luruicheng891/Study-Focus-Meter/项目架构.png

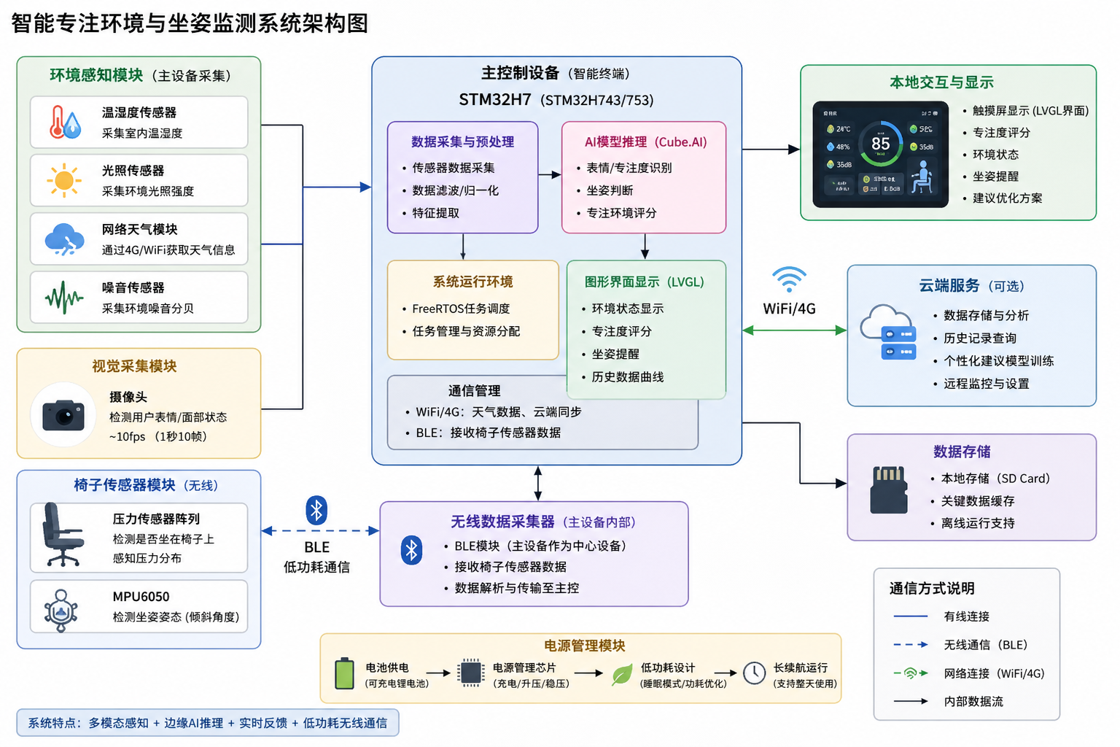
项目架构.png
