luruicheng891/Study-Focus-Meter/开发笔记.md

# AI 学习状态监测仪 开发笔记

---

## 一、项目元信息

| 项目 | 内容 |
|---|---|
| 产品名称 | AI 学习状态监测仪 |
| 固件版本 | V1.5 |
| MCU | STM32H723ZGT6 (Cortex-M7, 550MHz) |
| 摄像头模块 | OV2640 (SCCB 接口, 最大 1600×1200) |
| LCD 模块 | ILI9341 (240×320 原始, 横屏使用为 320×240, SPI 接口, RGB565) |
| 温湿度传感器 | AHT20 (I2C, 地址 0x38) |
| 光照传感器 | BH1750FVI (I2C, 地址 0x23, ADDR=GND) |
| 六轴传感器 | MPU6050 (从机端, 通过蓝牙透传) |
| 蓝牙模块 | 安信可 PB-03F (BLE 5.2, UART 透传) |

### 开发环境

| 项目 | 版本/说明 |
|---|---|
| IDE | Keil MDK-ARM V5 |
| 编译器 | ARM Compiler V5 (armcc) |
| 固件库 | STM32H7xx HAL Driver |
| RTOS | FreeRTOS Kernel V10.3.1 + CMSIS-RTOS V2 |
| GUI 库 | LVGL v8.3.11 |
| 调试器 | ST-Link / J-Link |

### 关键文档链接

- 数据手册: [STM32H723ZGT6 Datasheet](https://www.st.com/resource/en/datasheet/stm32h723zg.pdf)
- 参考手册: [RM0468 - STM32H723/733 Reference Manual](https://www.st.com/resource/en/reference_manual/rm0468-stm32h723733-stm32h725735-and-stm32h730-value-line-advanced-armbased-32bit-mcus-stmicroelectronics.pdf)
- OV2640 数据手册: OV2640 Camera Module Datasheet (Omnivision)
- ILI9341 数据手册: ILI9341 TFT LCD Controller Datasheet

---

## 二、硬件抽象层笔记

### 2.1 时钟树配置

```
HSE = 25MHz (外部高速晶振，假设板载为 25MHz)

PLL1 配置:
  PLLM = 10  → VCO 输入 = 25MHz / 10 = 2.5MHz
  PLLN = 220 → VCO 输出 = 2.5MHz × 220 = 550MHz
  PLLP = 1   → SYSCLK = 550MHz / 1 = 550MHz
  PLLQ = 2   → PLL1Q = 275MHz
  PLLR = 2   → PLL1R = 275MHz

总线时钟:
  SYSCLK   = 550 MHz
  AHB/HCLK = 550 / 2 = 275 MHz
  APB1     = 275 / 2 = 137.5 MHz
  APB2     = 275 / 2 = 137.5 MHz
  APB3     = 275 / 2 = 137.5 MHz
  APB4     = 275 / 2 = 137.5 MHz

电压调节: VOS0 (最高性能模式)
Flash 等待周期: FLASH_LATENCY_3
```

**注意事项:**
- 使用 `PWR_LDO_SUPPLY` 供电模式
- 必须等待 `PWR_FLAG_VOSRDY` 后才能配置 PLL
- ICache 和 DCache 均已开启 (`SCB_EnableICache()` / `SCB_EnableDCache()`)

### 2.2 MPU 配置

| 区域 | 基地址 | 大小 | 属性 |
|---|---|---|---|
| Region 0 | 0x24000000 (AXI SRAM) | 512KB | Full Access, Bufferable, Cacheable, Shareable |

> 用途: 摄像头 DMA 帧缓冲区放置在 AXI SRAM，配置为可缓存+可共享，确保 DMA 与 CPU 数据一致性。

### 2.3 引脚分配表

#### DCMI 接口 (OV2640 摄像头)

| 引脚 | 信号名 | 类型 | 备注 |
|---|---|---|---|
| PA6 | DCMI_PIXCLK | AF13 推挽 | 像素时钟 |
| PG9 | DCMI_VSYNC | AF13 推挽 | 垂直同步 |
| PC6 | DCMI_D0 | AF13 推挽 | 数据位 0 |
| PC7 | DCMI_D1 | AF13 推挽 | 数据位 1 |
| PG10 | DCMI_D2 | AF13 推挽 | 数据位 2 (注释标注) |
| PG11 | DCMI_D3 | AF13 推挽 | 数据位 3 (注释标注) |
| PE4 | DCMI_D4 | AF13 推挽 | 数据位 4 |
| PD3 | DCMI_D5 | AF13 推挽 | 数据位 5 |
| PE5 | DCMI_D6 | AF13 推挽 | 数据位 6 |
| PE6 | DCMI_D7 | AF13 推挽 | 数据位 7 |
| PF13 | OV2640_PWDN | GPIO 推挽输出 | 电源控制 (高=休眠) |

#### SCCB 接口 (软件模拟 I2C)

| 引脚 | 信号名 | 类型 | 备注 |
|---|---|---|---|
| PF14 | SCCB_SCL | GPIO 开漏输出 | I2C 时钟, 软件模拟 |
| PF15 | SCCB_SDA | GPIO 开漏输出 | I2C 数据, 软件模拟 |

> OV2640 设备地址: 0x60

#### SPI1 (LCD ILI9341)

| 引脚 | 信号名 | 类型 | 备注 |
|---|---|---|---|
| PB3 | SPI1_SCK | AF5 推挽 | SPI 时钟 |
| PB5 | SPI1_MOSI | AF5 推挽 | SPI 数据输出 |
| PD0 | LCD_CS | GPIO 推挽输出 | 片选 (低有效) |
| PD1 | LCD_DC | GPIO 推挽输出 | 数据/命令选择 |
| PD2 | LCD_RST | GPIO 推挽输出 | 硬件复位 (低有效) |
| PB4 | LCD_LED | GPIO 推挽输出 | 背光控制 (高=亮) |

#### USART1 (调试串口 + 显示模式命令)

| 引脚 | 信号名 | 类型 | 备注 |
|---|---|---|---|
| PA9 | USART1_TX | AF7 推挽 | 波特率 115200, 非阻塞环形缓冲 + TXE 中断 |
| PA10 | USART1_RX | AF7 输入(上拉) | 波特率 115200, RXNE 中断接收单字节命令 |

> 命令字符: `'C'`/`'c'` → 摄像头模式; `'W'`/`'w'` → 天气仪表板模式 (相对摄像头模式 180° 翻转)。
> 其它字符忽略。fputc 已重定向为非阻塞实现, 防止多任务并发 printf 死锁。

#### LED

| 引脚 | 信号名 | 类型 | 备注 |
|---|---|---|---|
| PG7 | LED1 | GPIO 推挽输出 | 低电平点亮 |

#### 软件模拟I2C

| 引脚 | 信号名 | 类型 | 备注 |
| ---- | --- | --- | --- |
| PB8  | SCL | GPIO推挽输出 | I2C时钟线 |
| PB9  | SDA | GPIO推挽输出 | I2C数据线 |

W02蓝牙模块引脚定义


### 2.4 外设配置参数

#### SPI1 (LCD) + DMA

```c
// SPI1 配置
Mode              = SPI_MODE_MASTER
Direction         = SPI_DIRECTION_2LINES_TXONLY  // 仅发送
DataSize          = SPI_DATASIZE_8BIT
CLKPolarity       = SPI_POLARITY_LOW   (CPOL=0)
CLKPhase          = SPI_PHASE_1EDGE    (CPHA=0)
BaudRatePrescaler = SPI_BAUDRATEPRESCALER_8
// APB2=137.5MHz, 分频8 → SPI CLK ≈ 17.2MHz
FirstBit          = SPI_FIRSTBIT_MSB

// DMA1_Stream0 配置 (SPI1_TX)
Request           = DMA_REQUEST_SPI1_TX (38)
Direction         = DMA_MEMORY_TO_PERIPH
PeriphDataAlignment = DMA_PDATAALIGN_BYTE
MemDataAlignment    = DMA_MDATAALIGN_BYTE
Mode              = DMA_NORMAL
Priority          = DMA_PRIORITY_HIGH
FIFOMode          = DMA_FIFOMODE_DISABLE
```

> ⚠️ DMA 缓冲区必须在 AXI SRAM (0x24000000+), 不能在 DTCM (0x20000000)!

#### DCMI

```c
SynchroMode  = DCMI_SYNCHRO_HARDWARE   // 硬件同步
PCKPolarity  = DCMI_PCKPOLARITY_RISING  // 上升沿采样
VSPolarity   = DCMI_VSPOLARITY_LOW      // VS 低电平有效
HSPolarity   = DCMI_HSPOLARITY_LOW      // HS 低电平有效
CaptureRate  = DCMI_CR_ALL_FRAME        // 捕获所有帧
数据宽度      = 8 位
```

#### FreeRTOS 关键配置

```c
configTICK_RATE_HZ        = 1000        // 1ms 节拍
configTOTAL_HEAP_SIZE     = 15360       // 15KB 堆
configMAX_PRIORITIES      = 56
configMINIMAL_STACK_SIZE  = 128 words   // 512 bytes
configTIMER_TASK_STACK_DEPTH = 256 words
Heap 实现: heap_4.c
```

#### 任务列表

| 任务名 | 函数 | 栈大小 | 优先级 | 功能 |
|---|---|---|---|---|
| LVGL_Task | LVGL_Task | 512 words (2KB) | osPriorityAboveNormal | 调用 lv_timer_handler() 驱动 LVGL |
| Camera_task | Camera_task | 1024 words (4KB) | osPriorityNormal | 摄像头采集 + LVGL canvas 显示 |
| Sensor_Task | Sensor_Task | 512 words (2KB) | osPriorityNormal | AHT20 + BH1750 + MAX9814 聚合 |
| DisplayTask | DisplayTask | 512 words (2KB) | osPriorityNormal | 三屏切换编排 + 实时刷新 + Reminder/ScreenSaver (100ms) |
| Weather_RxTask | Weather_RxTask | 512 words (2KB) | osPriorityNormal | ESP-01 USART3 帧 → cJSON → 队列 |
| Slave_RxTask | Slave_RxTask | 512 words (2KB) | osPriorityNormal | ESP32 USART2 帧 → cJSON → 队列 |
| AI_Infer | AI_InferTask | 3072 words (12KB) | osPriorityBelowNormal | CubeAI 推理 |
| Touch_Task | Touch_Task | 512 words (2KB) | osPriorityNormal | XPT2046 扫描 + LVGL indev + 校准 |
| Fusion_Task | Fusion_Task | 1024 words (4KB) | osPriorityLow | 多模态融合评分, 1s 周期 (视觉40+坐姿30+环境20+时长10) |
| State_Task | State_Task | 512 words (2KB) | osPriorityNormal | 学习会话状态机, 200ms 周期 (IDLE/PICKING/LEARNING/AWAY/PAUSED/SUMMARY) |

> 历史命名: 原 `Weather_Task` 已拆分为 `DisplayTask` (LVGL 渲染) 与 `Weather_RxTask` (数据接收), 详见第十一节重构记录。
> `Fusion_Task` / `State_Task` 为后续新增的融合与状态机任务, 配合 `LearningScreen` / `LearningReport` / `Reminder` / `ScreenSaver` 等纯 UI/逻辑模块 (无独立任务, 由 DisplayTask 驱动)。
> 界面流程与数据流详见 `项目架构.md` 的「界面流程与数据流」一节。

#### 中断优先级分配

| 中断源 | 抢占优先级 | 子优先级 | 用途 |
|---|---|---|---|
| DCMI / DMA2_Stream7 | 0 | 0 | 摄像头帧采集 (最高) |
| SPI1 DMA1_Stream0 | 1 | 0 | LCD SPI DMA 传输 |
| SPI1 | 1 | 1 | SPI 错误处理 |
| TIM7 | 3 | 0 | LVGL 1ms 心跳 |
| USART3 / DMA1_Stream1 | 6 | 0/1 | ESP-01 接收 (FreeRTOS 安全范围) |
| USART2 / DMA1_Stream3 | 6 | 0/1 | ESP32 BLE 透传接收 (FreeRTOS 安全范围) |
| USART1 | 6 | 0 | 调试串口 + 命令接收 (FreeRTOS 安全范围) |

---

## 三、驱动与中间件笔记

### 3.1 OV2640 摄像头驱动

- 像素格式: RGB565
- 采集分辨率: 400×300 (OV2640 输出)
- 显示分辨率: 240×240 (DCMI 硬件裁剪后)
- DMA 缓冲区: 位于 AXI SRAM (0x24000000)
- DMA 缓冲区大小: `240 × 240 × 2 / 4 = 28800` (32 位字)
- 传输模式: DMA 连续模式 (Continuous)

**帧处理流程:**
1. DCMI 中断回调设置 `DCMI_FrameState = 1`
2. Camera_task 检测到标志后:
   - 调用 `SCB_InvalidateDCache_by_Addr()` 使 DCache 无效化
   - 调用 `LCD_DrawBuffer()` 将帧数据刷新到 LCD

### 3.2 LCD ILI9341 驱动 (SPI1 + DMA)

- 通信方式: SPI1 (仅发送, 无 MISO) + DMA1_Stream0 加速
- 屏幕尺寸: 240×320
- 颜色格式: RGB565 (16bit)
- SPI 时钟: APB2/8 ≈ 17.2MHz
- DMA 通道: DMA1_Stream0, DMAMUX request = DMA_REQUEST_SPI1_TX (38)

**DMA 传输架构:**
- Ping-pong 双缓冲: `lcd_dma_buf[2][1024]` (每个 buffer 512 像素)
- 缓冲区位置: AXI SRAM 0x24040000 (DTCM 不可被 DMA 访问!)
- 传输前调用 `SCB_CleanDCache_by_Addr()` 刷新 DCache
- DMA 完成中断 → `HAL_SPI_TxCpltCallback()` → 清除 busy 标志
- `LCD_DMA_Wait()` 带超时保护，防止 DMA 异常时死循环

**批量传输流程 (LCD_DrawBuffer):**
1. 设置窗口 (阻塞 SPI 发送命令字节)
2. 切换 DC 为数据模式，保持 CS 低
3. 循环: CPU 在 buf[idx] 做字节序转换 → 等待上一次 DMA 完成 → 启动 DMA 发送 → 切换 idx
4. 等待最后一次 DMA 完成 → 释放 CS

**中断配置:**
- DMA1_Stream0_IRQHandler → `HAL_DMA_IRQHandler(&hdma_spi1_tx)`
- SPI1_IRQHandler → `HAL_SPI_IRQHandler(&hlcd_spi)` (错误处理)

### 3.3 I2C 软件模拟驱动

- 实现方式: GPIO bit-bang (非硬件 I2C)
- 引脚: PB8 (SCL) / PB9 (SDA), 开漏 + 内部上拉
- 速率: ~100kHz (通过 `I2C_DELAY_US = 5` 控制)
- 源文件: `Communication/I2C.c`

**API 接口:**
```c
void    I2C_Sim_Init(void);                                              // GPIO 初始化
uint8_t I2C_WriteData(uint8_t dev_addr, uint8_t reg_addr, uint8_t *data, uint16_t len);
uint8_t I2C_ReadData(uint8_t dev_addr, uint8_t reg_addr, uint8_t *buffer, uint16_t len);
```

> 注意: `dev_addr` 为 7 位地址，函数内部自动左移并添加 R/W 位。

### 3.4 MPU6050 六轴传感器驱动

- 通信接口: 软件 I2C (PB8/PB9)
- 设备地址: 0x68
- 采样率: 100Hz
- 陀螺仪量程: ±2000°/s
- 加速度计量程: ±16g
- 数字低通滤波: DLPF 带宽 5Hz
- 源文件: `Communication/MPU6050.c`

**初始化流程:**
1. 写 `PWR_MGMT_1 = 0x01` → 退出睡眠，选择 X 轴陀螺仪 PLL 作为时钟源
2. 写 `PWR_MGMT_2 = 0x00` → 使能所有轴
3. 写 `SMPLRT_DIV = 0x09` → 采样率分频 (100Hz)
4. 写 `CONFIG = 0x06` → DLPF 配置
5. 写 `GYRO_CONFIG = 0x18` → 陀螺仪 ±2000°/s
6. 写 `ACCEL_CONFIG = 0x18` → 加速度计 ±16g

**数据读取:**
- `MPU6050_GetData()` — 逐寄存器读取 (12 次 I2C 事务)
- `MPU6050_GetDataFast()` — 从 0x3B 连续读取 14 字节 (1 次 I2C 事务，推荐使用)

**寄存器映射 (连续读取 buffer[0..13]):**

| 偏移 | 内容 |
|---|---|
| [0:1] | AccX (高:低) |
| [2:3] | AccY |
| [4:5] | AccZ |
| [6:7] | Temperature (未使用) |
| [8:9] | GyroX |
| [10:11] | GyroY |
| [12:13] | GyroZ |

### 3.5 LVGL 集成

- 版本: v8.3.11
- 颜色深度: 16 bit (RGB565)
- 显示端口: `lv_port_disp.c` (位于 `LVGL/examples/porting/`)
- 刷屏回调: 调用 `LCD_SetWindows()` + `LCD_WriteDataBuffer()`
- 心跳源: TIM7 基本定时器, 1ms 中断调用 `lv_tick_inc(1)`
- `LV_TICK_CUSTOM = 0` (使用手动 tick 方式)

### 3.5.1 TIM7 LVGL 心跳定时器

- 源文件: `SYSTEM/TIM.c`, `SYSTEM/TIM.h`
- 定时器: TIM7 (基本定时器, 挂在 APB1 总线)
- 实现方式: 直接寄存器操作 (未启用 `HAL_TIM_MODULE_ENABLED`, 减少代码体积)
- 时钟来源: APB1 Timer Clock = 275MHz (APB1 分频≠1 时, Timer Clock = 2 × APB1)

**定时器参数:**

| 参数 | 值 | 说明 |
|---|-----|---|
| PSC | 274 | 275MHz / 275 = 1MHz 计数频率 |
| ARR | 999 | 1MHz / 1000 = 1kHz 中断频率 |
| 中断周期 | 1ms | 精确匹配 LVGL tick 需求 |
| NVIC 优先级 | (3, 0) | 低于 DCMI(0,x) 和 SPI(1,x) |

**API:**
```c
void TIM7_Init(void);       // 初始化并启动 TIM7, 在 lv_init() 之后调用
void TIM7_IRQHandler(void); // 中断服务函数, 调用 lv_tick_inc(1)
```

**使用方式:**
```c
#include "TIM.h"
// 在 lv_init() 之后调用
TIM7_Init();
```

> ⚠️ `TIM7_IRQHandler` 已在 `SYSTEM/TIM.c` 中定义，确保 `stm32h7xx_it.c` 中不要重复定义该函数。

### 3.6 资源占用

| 资源 | 使用情况 | 备注 |
|---|---|---|
| AXI SRAM 0x24000000 | 摄像头 DCMI 帧缓冲 ~115.2KB | 240×240×2 bytes |
| AXI SRAM 0x24040000 | LCD SPI DMA 双缓冲 2KB | ping-pong, 32 字节对齐 |
| AXI SRAM 0x24040800 | USART3 RX (ESP-01) 256B | 32 字节对齐 |
| AXI SRAM 0x24040900 | MAX9814 ADC 循环采集 1KB | 32 字节对齐 |
| AXI SRAM 0x24040D00 | USART2 RX (ESP32 BLE) 256B | 32 字节对齐 |
| AXI SRAM 0x24040E00+ | 空闲, 新增 DMA 缓冲从此起 | 32 字节对齐 |
| DTCM (0x20000000) | 栈、堆、普通变量 | DMA 不可访问! |
| FreeRTOS Heap | 40KB (heap_4) | 动态任务/队列/cJSON 分配 |
| Camera_task 栈 | 4KB | 含 LCD 刷屏操作 |
| AI_Infer 栈 | 12KB | CubeAI 推理 |
| DMA1_Stream0 | SPI1 TX (LCD) | DMAMUX request 38 |
| DMA1_Stream1 | USART3 RX (ESP-01) | DMAMUX USART3_RX |
| DMA1_Stream2 | ADC2 (MAX9814) | LL 配置 |
| DMA1_Stream3 | USART2 RX (ESP32 BLE) | DMAMUX USART2_RX |
| DMA2_Stream7 | DCMI RX (摄像头) | 循环模式 |
| TIM7 | LVGL 1ms 心跳 | 寄存器直接配置, 无 HAL TIM 依赖 |

### 3.7 AHT20 温湿度传感器

- 通信接口: 软件 I2C (PB8=SCL, PB9=SDA)
- 设备地址: 0x38 (7-bit)
- 供电: 3.3V
- 源文件: `Sensor/AHT20.c`, `Sensor/AHT20.h`

**协议特点:**
- AHT20 的 I2C 读取不使用标准寄存器地址方式
- 读状态/数据时直接发 [地址+R] 然后读 N 字节 (无需先写寄存器地址)
- 发命令时: [地址+W] + 命令字节 + 参数字节

**初始化流程:**
1. 上电等待 40ms
2. 发送初始化命令: `0xBE 0x08 0x00`
3. 等待 500ms
4. 检查状态字节的 CAL 位 (bit3)，未校准则软复位重试

**测量流程:**
1. 发送触发测量命令: `0xAC 0x33 0x00`
2. 等待 80ms (典型测量时间 75ms)
3. 轮询状态字节 bit7 (busy)，等待清零
4. 直接读取 7 字节: [状态][湿度H][湿度M][湿度L|温度H][温度M][温度L][CRC]
5. 解析 20 位湿度和 20 位温度原始数据

**数据转换:**
```c
// 湿度: humidity_x100 = raw_humi * 10000 / 2^20 (单位 0.01%)
// 温度: temp_x100 = raw_temp * 20000 / 2^20 - 5000 (单位 0.01°C)
// 注意: 必须用 uint64_t 中间运算防止 32 位溢出!
*humidity = (uint32_t)(((uint64_t)ct[0] * 10000) / 1048576);
*temperature = (int32_t)(((uint64_t)ct[1] * 20000) / 1048576 - 5000);
```

**踩坑记录:**
- `ct[0] * 10000UL` 在 32 位下会溢出 (最大值 1048575 × 10000 > UINT32_MAX)，导致湿度显示为负数
- 必须使用 `(uint64_t)ct[0] * 10000` 避免溢出

**AHT20 通信时序图:**

```
┌─────────────────────────────────────────────────────────────────────────────────┐
│                          AHT20 初始化时序图                                        │
├─────────────────────────────────────────────────────────────────────────────────┤
│                                                                                  │
│  MCU                 AHT20 (0x38)                    说明                       │
│   │                       │                          │                          │
│   │  START                │                          │  I2C 起始条件            │
│   ├───────────────────────┼──────────────────────────►                           │
│   │                       │                          │                          │
│   │  [0x38 << 1] + W =   │                          │  设备地址 + 写位         │
│   │  0x70                 │                          │  (7位地址左移1位)        │
│   ├───────────────────────┼──────────────────────────►                           │
│   │                       │                          │                          │
│   │                       │  ACK                     │  设备应答               │
│   │◄──────────────────────┼──────────────────────────┤                          │
│   │                       │                          │                          │
│   │  0xBE (Init CMD)      │                          │  初始化命令字            │
│   ├───────────────────────┼──────────────────────────►                           │
│   │                       │                          │                          │
│   │                       │  ACK                     │                          │
│   │◄──────────────────────┼──────────────────────────┤                          │
│   │                       │                          │                          │
│   │  0x08 (参数1)          │                          │  使能校准                │
│   ├───────────────────────┼──────────────────────────►                           │
│   │                       │                          │                          │
│   │                       │  ACK                     │                          │
│   │◄──────────────────────┼──────────────────────────┤                          │
│   │                       │                          │                          │
│   │  0x00 (参数2)          │                          │  保留位                  │
│   ├───────────────────────┼──────────────────────────►                           │
│   │                       │                          │                          │
│   │                       │  ACK                     │                          │
│   │◄──────────────────────┼──────────────────────────┤                          │
│   │                       │                          │                          │
│   │  STOP                 │                          │  I2C 停止条件            │
│   ├───────────────────────┼──────────────────────────►                           │
│   │                       │                          │                          │
│   │  ████████████████████ │                          │  等待 500ms             │
│   │  (500ms 延迟)          │                          │  (上电稳定+初始化)      │
│   │                       │                          │                          │
└─────────────────────────────────────────────────────────────────────────────────┘

┌─────────────────────────────────────────────────────────────────────────────────┐
│                          AHT20 读取状态时序图                                     │
├─────────────────────────────────────────────────────────────────────────────────┤
│                                                                                  │
│  MCU                 AHT20 (0x38)                    说明                       │
│   │                       │                          │                          │
│   │  START                │                          │  I2C 起始条件            │
│   ├───────────────────────┼──────────────────────────►                           │
│   │                       │                          │                          │
│   │  [0x38 << 1] + R =   │                          │  设备地址 + 读位         │
│   │  0x71                 │                          │                          │
│   ├───────────────────────┼──────────────────────────►                           │
│   │                       │                          │                          │
│   │                       │  ACK                     │                          │
│   │◄──────────────────────┼──────────────────────────┤                          │
│   │                       │                          │                          │
│   │  [读取状态字节]         │                          │  AHT20 直接发送1字节     │
│   │◄──────────────────────┼──────────────────────────┤                          │
│   │                       │                          │                          │
│   │  NACK (最后字节)       │                          │  发送非应答              │
│   ├───────────────────────┼──────────────────────────►                           │
│   │                       │                          │                          │
│   │  STOP                 │                          │                          │
│   ├───────────────────────┼──────────────────────────►                           │
│   │                       │                          │                          │
│   │  状态字节格式:          │                          │                          │
│   │  [7]   [6]   [5]  [4] │  [3]   [2]   [1]   [0]  │                          │
│   │  Busy  Reserved Mode[2:0] CAL  Reserved         │                          │
│   │  bit7=1: 正在测量      │                          │                          │
│   │  bit3=1: 校准使能      │                          │                          │
│   │  (需等待校准置位)      │                          │                          │
└─────────────────────────────────────────────────────────────────────────────────┘

┌─────────────────────────────────────────────────────────────────────────────────┐
│                          AHT20 触发测量+读取数据时序图                             │
├─────────────────────────────────────────────────────────────────────────────────┤
│                                                                                  │
│  MCU                 AHT20 (0x38)                    说明                       │
│   │                       │                          │                          │
│   │  START                │                          │                          │
│   ├───────────────────────┼──────────────────────────►                           │
│   │                       │                          │                          │
│   │  [0x38 << 1] + W =   │                          │  设备地址 + 写位         │
│   │  0x70                 │                          │                          │
│   ├───────────────────────┼──────────────────────────►                           │
│   │                       │  ACK                     │                          │
│   │◄──────────────────────┼──────────────────────────┤                          │
│   │                       │                          │                          │
│   │  0xAC (测量命令)        │                          │  触发测量命令            │
│   ├───────────────────────┼──────────────────────────►                           │
│   │                       │  ACK                     │                          │
│   │◄──────────────────────┼──────────────────────────┤                          │
│   │                       │                          │                          │
│   │  0x33 (参数1)          │                          │  湿度20bit + 温度20bit   │
│   ├───────────────────────┼──────────────────────────►                           │
│   │                       │  ACK                     │                          │
│   │◄──────────────────────┼──────────────────────────┤                          │
│   │                       │                          │                          │
│   │  0x00 (参数2)          │                          │  保留位                  │
│   ├───────────────────────┼──────────────────────────►                           │
│   │                       │  ACK                     │                          │
│   │◄──────────────────────┼──────────────────────────┤                          │
│   │                       │                          │                          │
│   │  STOP                 │                          │                          │
│   ├───────────────────────┼──────────────────────────►                           │
│   │                       │                          │                          │
│   │  ████████████████████ │                          │  等待 80ms (典型75ms)   │
│   │  (80ms 延迟)           │                          │                          │
│   │                       │                          │                          │
│   │  [轮询 Busy 位]        │                          │  等待 bit7=0             │
│   │  ─────────────────────►│  读状态                   │  (最多额外100ms)         │
│   │                       │                          │                          │
│   │  START                │                          │                          │
│   ├───────────────────────┼──────────────────────────►                           │
│   │                       │                          │                          │
│   │  [0x38 << 1] + R =   │                          │  设备地址 + 读位         │
│   │  0x71                 │                          │                          │
│   ├───────────────────────┼──────────────────────────►                           │
│   │                       │  ACK                     │                          │
│   │◄──────────────────────┼──────────────────────────┤                          │
│   │                       │                          │                          │
│   │  [Byte0: 状态]         │  ACK                     │  状态字节                │
│   │◄──────────────────────┼──────────────────────────┤                          │
│   │                       │                          │                          │
│   │  [Byte1: 湿度H]        │  ACK                     │  湿度[19:12]             │
│   │◄──────────────────────┼──────────────────────────┤                          │
│   │                       │                          │                          │
│   │  [Byte2: 湿度M]        │  ACK                     │  湿度[11:4]              │
│   │◄──────────────────────┼──────────────────────────┤                          │
│   │                       │                          │                          │
│   │  [Byte3: 湿度L|温度H]   │  ACK                     │  湿度[3:0]|温度[19:16]   │
│   │◄──────────────────────┼──────────────────────────┤                          │
│   │                       │                          │                          │
│   │  [Byte4: 温度M]        │  ACK                     │  温度[15:8]              │
│   │◄──────────────────────┼──────────────────────────┤                          │
│   │                       │                          │                          │
│   │  [Byte5: 温度L]        │  ACK                     │  温度[7:0]               │
│   │◄──────────────────────┼──────────────────────────┤                          │
│   │                       │                          │                          │
│   │  [Byte6: CRC]         │  NACK (最后字节)          │  CRC-8 校验 (可选)       │
│   │◄──────────────────────┼──────────────────────────┤                          │
│   │                       │                          │                          │
│   │  STOP                 │                          │                          │
│   ├───────────────────────┼──────────────────────────►                           │
│   │                       │                          │                          │
│   │  数据解析:              │                          │                          │
│   │  Humidity = [1][2]<<4 | [3]>>4  (20bit)           │                          │
│   │  Temperature = [3]&0x0F)<<16 | [4]<<8 | [5]       │                          │
│   │                       │                          │                          │
└─────────────────────────────────────────────────────────────────────────────────┘
```

### 3.8 BH1750FVI 光照传感器

- 通信接口: 软件 I2C (PB8=SCL, PB9=SDA)，与 AHT20 共享总线
- 设备地址: 0x23 (ADDR 引脚接 GND)
- 供电: 2.4~3.6V (典型 3.0V)
- 量程: 1 ~ 65535 lx (H-Resolution Mode)
- 分辨率: 1 lx (H-Res), 0.5 lx (H-Res2), 4 lx (L-Res)
- 源文件: `Sensor/BH1750.c`, `Sensor/BH1750.h`

**I2C 地址选择:**

| ADDR 引脚 | 7-bit 地址 | 二进制 |
|---|---|---|
| GND (≤0.3VCC) | 0x23 | 0100011 |
| VCC (≥0.7VCC) | 0x5C | 1011100 |

**指令集:**

| 指令 | Opcode | 说明 |
|---|---|---|
| Power Down | 0x00 | 关机，无活动状态 |
| Power On | 0x01 | 等待测量命令 |
| Reset | 0x07 | 复位数据寄存器 (需先 Power On) |
| 连续 H-Res | 0x10 | 1lx 分辨率, 120ms |
| 连续 H-Res2 | 0x11 | 0.5lx 分辨率, 120ms |
| 连续 L-Res | 0x13 | 4lx 分辨率, 16ms |
| 单次 H-Res | 0x20 | 1lx, 120ms, 测完自动 Power Down |
| 单次 H-Res2 | 0x21 | 0.5lx, 120ms, 测完自动 Power Down |
| 单次 L-Res | 0x23 | 4lx, 16ms, 测完自动 Power Down |

**写命令格式:**
```
ST + [SlaveAddr + W] + Ack + [Opcode] + Ack + SP
```
> 重要: BH1750 不能在一次传输中接受多条命令，每条命令后必须插入 Stop!

**读数据格式:**
```
ST + [SlaveAddr + R] + Ack + [HighByte] + Ack + [LowByte] + NAck + SP
```

**光照计算公式:**
```c
// H-Resolution Mode:
lux = raw_data / 1.2 * (69 / MTreg)
// H-Resolution Mode2:
lux = raw_data / 1.2 * (69 / MTreg) / 2
```

**MTreg 灵敏度调节:**
- 默认值: 69 (0100_0101)
- 范围: 31 ~ 254
- 设置高位: 发送 `01000_MT[7:5]`
- 设置低位: 发送 `011_MT[4:0]`
- 灵敏度倍数 = MTreg / 69

**本项目使用方式:**
- 连续高分辨率模式 (0x10)，初始化时启动一次，之后每秒读取最新值
- 不调用 `BH1750_MeasureOnce()` (该函数内部用 `HAL_Delay`，在 FreeRTOS 中不安全)
- 使用 `BH1750_StartMeasurement()` + `BH1750_ReadLux()` 分离模式

**BH1750 通信时序图:**

```
┌─────────────────────────────────────────────────────────────────────────────────┐
│                          BH1750 上电+复位时序图                                   │
├─────────────────────────────────────────────────────────────────────────────────┤
│                                                                                  │
│  MCU                BH1750 (0x23)                    说明                       │
│   │                      │                          │                          │
│   │  START               │                          │  I2C 起始条件             │
│   ├──────────────────────┼─────────────────────────►                           │
│   │                      │                          │                          │
│   │  [0x23 << 1] + W =  │                          │  设备地址 + 写位          │
│   │  0x46                │                          │  (0x23 << 1 = 0x46)      │
│   ├──────────────────────┼─────────────────────────►                           │
│   │                      │  ACK                     │  设备应答                 │
│   │◄─────────────────────┼──────────────────────────┤                          │
│   │                      │                          │                          │
│   │  0x01 (Power On)     │                          │  上电命令                 │
│   ├──────────────────────┼─────────────────────────►                           │
│   │                      │  ACK                     │                          │
│   │◄─────────────────────┼──────────────────────────┤                          │
│   │                      │                          │                          │
│   │  STOP                │                          │  I2C 停止条件             │
│   ├──────────────────────┼─────────────────────────►                           │
│   │                      │                          │                          │
│   │  ████                │                          │  等待 10ms (Datasheet)   │
│   │  (10ms 延迟)          │                          │                          │
│   │                      │                          │                          │
│   │  START               │                          │  复位需要重新 START       │
│   ├──────────────────────┼─────────────────────────►                           │
│   │                      │                          │                          │
│   │  [0x23 << 1] + W =  │                          │                          │
│   │  0x46                │                          │                          │
│   ├──────────────────────┼─────────────────────────►                           │
│   │                      │  ACK                     │                          │
│   │◄─────────────────────┼──────────────────────────┤                          │
│   │                      │                          │                          │
│   │  0x07 (Reset)        │                          │  复位命令                  │
│   ├──────────────────────┼─────────────────────────►                           │
│   │                      │  ACK                     │                          │
│   │◄─────────────────────┼──────────────────────────┤                          │
│   │                      │                          │                          │
│   │  STOP                │                          │  停止条件                 │
│   ├──────────────────────┼─────────────────────────►                           │
│   │                      │                          │                          │
└─────────────────────────────────────────────────────────────────────────────────┘

┌─────────────────────────────────────────────────────────────────────────────────┐
│                          BH1750 连续测量模式时序图                                 │
├─────────────────────────────────────────────────────────────────────────────────┤
│                                                                                  │
│  MCU                BH1750 (0x23)                    说明                       │
│   │                      │                          │                          │
│   │  START               │                          │                          │
│   ├──────────────────────┼─────────────────────────►                           │
│   │                      │                          │                          │
│   │  [0x23 << 1] + W =  │                          │                          │
│   │  0x46                │                          │                          │
│   ├──────────────────────┼─────────────────────────►                           │
│   │                      │  ACK                     │                          │
│   │◄─────────────────────┼──────────────────────────┤                          │
│   │                      │                          │                          │
│   │  0x10 (连续H-Res)     │                          │  启动连续测量             │
│   │                      │                          │  1lx分辨率, 120ms/次     │
│   ├──────────────────────┼─────────────────────────►                           │
│   │                      │  ACK                     │                          │
│   │◄─────────────────────┼──────────────────────────┤                          │
│   │                      │                          │                          │
│   │  STOP                │                          │  ★ 每条命令后必须STOP    │
│   ├──────────────────────┼─────────────────────────►                           │
│   │                      │                          │                          │
│   │  ████████████████    │                          │  等待 120ms              │
│   │  (120ms 测量时间)     │                          │                          │
│   │                      │                          │                          │
│   │  [可读取数据]         │                          │  测量完成后可读取        │
│   │                      │                          │                          │
└─────────────────────────────────────────────────────────────────────────────────┘

┌─────────────────────────────────────────────────────────────────────────────────┐
│                          BH1750 读取光照数据时序图                                  │
├─────────────────────────────────────────────────────────────────────────────────┤
│                                                                                  │
│  MCU                BH1750 (0x23)                    说明                       │
│   │                      │                          │                          │
│   │  START               │                          │  I2C 起始条件             │
│   ├──────────────────────┼─────────────────────────►                           │
│   │                      │                          │                          │
│   │  [0x23 << 1] + R =  │                          │  设备地址 + 读位         │
│   │  0x47                │                          │  (读地址 = 0x46 | 0x01) │
│   ├──────────────────────┼─────────────────────────►                           │
│   │                      │  ACK                     │                          │
│   │◄─────────────────────┼──────────────────────────┤                          │
│   │                      │                          │                          │
│   │  [高字节 MSB]        │  ACK                     │  光照值高8位             │
│   │◄─────────────────────┼───────────────────────── │                          │
│   │                      │                          │                          │
│   │  [低字节 LSB]        │  NACK (最后字节)          │  光照值低8位             │
│   │◄─────────────────────┼───────────────────────── │                          │
│   │                      │                          │                          │
│   │  STOP                │                          │  I2C 停止条件             │
│   ├──────────────────────┼─────────────────────────►                           │
│   │                      │                          │                          │
│   │  数据计算:            │                          │                          │
│   │  raw_lux = (MSB << 8) | LSB                     │                          │
│   │  lux = raw_lux / 1.2 * (69 / MTreg)             │                          │
│   │  (H-Resolution Mode, MTreg=69)                  │                          │
│   │  lux = raw_lux / 1.2 ≈ raw_lux * 0.833          │                          │
│   │                      │                          │                          │
└─────────────────────────────────────────────────────────────────────────────────┘

┌─────────────────────────────────────────────────────────────────────────────────┐
│                    BH1750 单次测量模式时序图 (One-Time Mode)                        │
├─────────────────────────────────────────────────────────────────────────────────┤
│                                                                                  │
│  MCU                BH1750 (0x23)                    说明                       │
│   │                      │                          │                          │
│   │  START               │                          │                          │
│   ├──────────────────────┼─────────────────────────►                           │
│   │                      │                          │                          │
│   │  [0x23 << 1] + W =  │                          │                          │
│   │  0x46                │                          │                          │
│   ├──────────────────────┼─────────────────────────►                           │
│   │                      │  ACK                     │                          │
│   │◄─────────────────────┼──────────────────────────┤                          │
│   │                      │                          │                          │
│   │  0x23 (单次H-Res)    │                          │  1lx分辨率, 120ms       │
│   │                      │                          │  测量完成后自动断电       │
│   ├──────────────────────┼─────────────────────────►                           │
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
│   │                      │  ACK                     │                          │
│   │◄─────────────────────┼──────────────────────────┤                          │
│   │                      │                          │                          │
│   │  STOP                │                          │  ★ 必须 STOP            │
│   ├──────────────────────┼─────────────────────────►                           │
│   │                      │                          │                          │
│   │  START               │                          │  ★ 必须重新 START       │
│   ├──────────────────────┼─────────────────────────►                           │
│   │                      │                          │                          │
│   │  [0x23 << 1] + W =  │                          │                          │
│   │  0x46                │                          │                          │
│   ├──────────────────────┼─────────────────────────►                           │
│   │                      │  ACK                     │                          │
│   │◄─────────────────────┼──────────────────────────┤                          │
│   │                      │                          │                          │
│   │  0x60 | (MT & 0x1F) │                          │  设置低位                │
│   │                      │                          │  [0x60-0x7F] + MT[4:0]  │
│   │                      │                          │  示例: MT=69(0x45)      │
│   │                      │                          │  → 0x60 | 0x05 = 0x65   │
│   ├──────────────────────┼─────────────────────────►                           │
│   │                      │  ACK                     │                          │
│   │◄─────────────────────┼──────────────────────────┤                          │
│   │                      │                          │                          │
│   │  STOP                │                          │                          │
│   ├──────────────────────┼─────────────────────────►                           │
│   │                      │                          │                          │
│   │  MTreg 范围: 31-254, 默认69                                            │
│   │  测量时间 = 基准时间 × MTreg / 69                                      │
│   │  灵敏度倍数 = MTreg / 69                                                │
│   │                      │                          │                          │
└─────────────────────────────────────────────────────────────────────────────────┘
```

### 3.9 传感器任务架构

**统一采集任务 (AHT20_Task):**
- AHT20 和 BH1750 在同一个 FreeRTOS 任务中顺序读取
- 共享 I2C 总线，单任务串行访问，无需互斥锁
- 采集周期: 1 秒
- 两个传感器独立初始化，任一个不在线不影响另一个工作

**数据流:**
```
Sensor_Task (1s 周期, 已替代旧的 AHT20_Task)
  ├── 读取 AHT20 温湿度
  ├── 读取 BH1750 光照
  ├── 读取 MAX9814 麦克风音量 (RMS → 0~100%)
  ├── 打包为 SensorData_t
  └── xQueueOverwrite(xSensorDataQueue)  → DisplayTask 消费 (LVGL 显示)
```

**数据结构:**
```c
typedef struct {
    int32_t  temperature;     // 温度, 单位 0.01°C
    uint32_t humidity;        // 湿度, 单位 0.01%
    uint32_t lux_x100;        // 光照, 单位 0.01 lx
    uint16_t soundIntensity;  // 麦克风音量 0~100 (百分比)
    uint32_t timestamp;       // FreeRTOS tick 时间戳
} SensorData_t;
```

**队列设计:**
- `xSensorDataQueue`: 长度 1，使用 `xQueueOverwrite` 始终保持最新值

**显示任务 (DisplayTask, 原 Weather_Task 已重命名):**
- 使用 `xQueuePeek` 读取最新数据 (不移除)
- 时间戳去重: 相同数据不重复刷新 UI
- 数据过期检测: 超过 3 秒未更新显示 "---" 离线状态
- LVGL 显示模式根据 `g_display_mode` 自动切换 (见 §3.12)
- 横屏 320×240 全屏天气仪表板, 左列网络天气 Hero 卡, 右列本地室内卡

**LVGL 显示布局 (天气模式, 横屏 320×240):**
```
┌──────────────────────────┬────────────────────────┐
│ Beijing                   │ INDOOR                 │
│  25.3 C  (28pt)           │  Temp                  │
│ Cloudy                    │   24.5 C  (28pt)       │
│ Feels 24.0 C              │  Humi                  │
│                           │   58%                  │
│ Humi    Wind     Pres     │  Lux                   │
│  62%    NE 2.5   1013     │   245                  │
│ (Hero 卡 156×196)         │ (室内卡 144×196)       │
└──────────────────────────┴────────────────────────┘
```

**LVGL 显示布局 (摄像头模式, 横屏 320×240):**
```
┌──────────────┬──────────────────┬──────────────┐
│              │   240×240 摄像头  │              │
│  40 px 留白  │     画面居中      │  40 px 留白  │
│              │                  │              │
└──────────────┴──────────────────┴──────────────┘
```

### 3.10 蓝牙通信 (W02 / PB-03F) + 从机数据接收 (USART2)

- 模块: 安信可 PB-03F (或 W02) BLE 蓝牙透传模块
- 芯片: PHY6252 (博通集成)
- 协议: Bluetooth 5.2 BLE
- 通信方式: UART 透传
- 链路: ESP32 (从机, 采集 MPU6050 + 压力传感器) → BLE 广播 → 主机端 W02/PB-03F → USART2

**说明:**
- MPU6050 不在本机 I2C 总线上，而是在从机端 (ESP32) 采集后通过 BLE 透传到主机
- 主机 USART2 接收从机发来的 IMU + 压力 JSON 数据
- 因此 PB8/PB9 I2C 总线上只有 AHT20 和 BH1750，不存在与 MPU6050 的总线冲突

**PB-03F 关键参数:**

| 参数 | 值 |
|---|-----|
| 蓝牙版本 | Bluetooth 5.2 |
| 发射功率 | 10 dBm |
| 接收灵敏度 | -93 dBm |
| TX 电流 | 11.5 mA |
| RX 电流 | 9.4 mA |
| 支持速率 | 125K / 500K / 1M / 2Mbps |
| 默认工作模式 | UART 透传 |

**主机 USART2 接收链路:**

- 引脚: PA2 = TX, PA3 = RX, 115200 baud, 8N1
- DMA: DMA1_Stream3 (`DMA_REQUEST_USART2_RX`), 循环模式
- DMA 缓冲: AXI SRAM `0x24040D00` (256B, 32 字节对齐)
- 中断: USART2 IRQ (6, 1) + DMA1_Stream3 IRQ (6, 0), IDLE 检测帧结束
- 分层架构:
  - **驱动层** `Communication/UART_ESP32.{c,h}`: 字节流分帧 (USART2 + DMA + IDLE)
  - **业务层** `Task/SlaveRxTask.{c,h}`: cJSON 解析、长度 1 队列、`Slave_GetLatest/WaitNew/GetStats` API

**JSON 报文格式 (来自 ESP32):**
```json
{"ts":1678901234567,
 "ax":0.12,"ay":-0.05,"az":9.81,
 "gx":0.01,"gy":-0.02,"gz":0.03,
 "press":101.32}
```
> ESP32 端 sprintf 拼接可能带尾随逗号 `,}`, 业务层 `sanitize_trailing_comma` 已做容错。

**数据结构 (`SlaveData_t`):**
```c
typedef struct {
    uint64_t ts;            // ESP32 端毫秒时间戳 (超过 uint32 范围)
    float    ax, ay, az;    // 加速度, g
    float    gx, gy, gz;    // 角速度, dps
    float    press;         // 气压, kPa
    uint32_t local_tick;    // 本机接收时刻 FreeRTOS tick
    uint32_t seq;           // 累计帧序号, 便于丢帧统计
} SlaveData_t;
```

**接收流程:**
```
ESP32 + MPU6050 + 压力 → BLE 广播 → W02 / PB-03F 透传 → USART2 RX (PA3)
   ↓ DMA1_Stream3 → AXI SRAM 0x24040D00 (256B)
IDLE 中断 (UART_ESP32.c::USART2_IRQ_Handler)
   ↓ SCB_InvalidateDCache → 拷贝到帧缓冲 → vTaskNotifyGiveFromISR
Slave_RxTask (Task/SlaveRxTask.c) 唤醒
   ├── UART_ESP32_TakeFrame(buf, max_len, &out_len)
   ├── sanitize_trailing_comma + cJSON 解析 → SlaveData_t
   ├── printf 调试到 USART1
   └── xQueueOverwrite(s_queue) (内部, 长度 1)
       ↓
   消费方调用 Slave_GetLatest() / Slave_WaitNew() 获取最新一帧
```

### 3.11 ESP-01 WiFi 天气数据 (USART3)

- 模块: ESP-01 (ESP8266 WiFi 模块)
- 通信接口: USART3 (PD8=TX, PB11=RX, 115200 baud)
- 协议: MQTT 透传 JSON 格式天气数据
- 接收方式: DMA 循环模式 + 空闲中断 (IDLE) 检测帧结束
- 分层架构 (重构后):
  - **驱动层** `Communication/UART_ESP01.{c,h}`: USART3 + DMA1_Stream1 + IDLE 分帧
  - **业务层** `Task/WeatherTask.{c,h}`: cJSON 解析、长度 1 队列、`Weather_GetLatest/WaitNew/GetStats` 消费 API
  - 驱动只负责"字节流分帧", 不参与协议解析; 业务侧通过 `UART_ESP01_BindRxTask + UART_ESP01_TakeFrame` 与驱动对话

**JSON 数据格式:**
```json
{"city":"Guangzhou","temp":29.0,"humi":76,"feel":33,"cond":"Patchy rain nearby","wind":4.0,"wdir":"E","pres":1009,"time":"00:05"}
```

**字段说明:**

| 字段 | 类型 | 说明 |
|---|---|---|
| city | string | 城市名 |
| temp | float | 温度 (°C) |
| humi | int | 湿度 (%) |
| feel | float | 体感温度 (°C) |
| cond | string | 天气状况描述 |
| wind | float | 风速 (m/s) |
| wdir | string | 风向 (E/W/S/N等) |
| pres | int | 气压 (hPa) |
| time | string | 时间 |

**接收流程:**
```
ESP-01 → USART3 RX (PB11) → DMA1_Stream1 → AXI SRAM 0x24040800 (256B)
   ↓ IDLE 中断 (UART_ESP01.c::USART3_IRQ_Handler)
SCB_InvalidateDCache → 拷贝到帧缓冲 → vTaskNotifyGiveFromISR
   ↓
Weather_RxTask (Task/WeatherTask.c) 唤醒
   ├── UART_ESP01_TakeFrame(buf, max_len, &out_len)
   ├── cJSON 解析 → WeatherInfo_t
   ├── printf 调试到 USART1 (走非阻塞 fputc)
   └── xQueueOverwrite(s_queue)
       ↓
   DisplayTask (Task/Display.c) 通过 Weather_GetLatest() 拉取, 更新 LVGL UI (city, temp, humi 等)
```

**踩坑记录:**

1. **DMA 缓冲区位置**: `rx_dma_buf` 必须放在 AXI SRAM 而非 DTCM, 使用
   `__attribute__((section(".ARM.__at_0x24040800"), aligned(32)))` 强制定位。
   紧跟 LCD DMA buffer (0x24040000~0x240407FF) 之后。
2. **DCache 一致性**: DMA 写入 AXI SRAM 后, CPU 读取前必须调用
   `SCB_InvalidateDCache_by_Addr()` 否则读到旧数据。
3. **中断优先级**: USART3 / DMA1_Stream1 优先级设为 6, 高于 FreeRTOS
   `configLIBRARY_MAX_SYSCALL_INTERRUPT_PRIORITY (5)`, 才能调用 FromISR API。
4. **GPIO 复用**: PD8=TX 需要使能 GPIOD 时钟; PB11=RX 使能 GPIOB 时钟。
5. **IDLE 中断**: HAL_UART_Receive_DMA() 启动循环 DMA 后, 必须手动
   `__HAL_UART_ENABLE_IT(&huart3, UART_IT_IDLE)` 启用空闲检测。
6. **每帧重启 DMA**: IDLE 触发后 `HAL_UART_DMAStop` 再 `HAL_UART_Receive_DMA` 重启,
   重置 DMA 计数器以接收下一帧。

**WeatherInfo_t 结构体:**
```c
typedef struct {
    char     city[20];      // 城市名
    int16_t  temp_x10;     // 温度, 单位 0.1°C (290 = 29.0°C)
    uint8_t  humi;         // 湿度, %
    int16_t  feel_x10;    // 体感温度, 0.1°C
    char     cond[32];     // 天气状况
    uint16_t wind_x10;    // 风速, 0.1 m/s
    char     wdir[4];      // 风向
    uint16_t pres;         // 气压, hPa
    char     time[8];      // 时间字符串
    uint32_t timestamp;   // 接收时刻 tick
} WeatherInfo_t;
```

**cJSON 适配 FreeRTOS:**
- 在 main.c 中通过 `cJSON_InitHooks()` 注册 `pvPortMalloc` / `vPortFree`
- 解析时分配的内存来自 FreeRTOS 堆 (heap_4)
- `cJSON_Delete()` 自动释放

---

### 3.12 显示模式切换 + USART1 非阻塞 printf

> 本节描述 V1.3 引入的运行时显示切换机制和 USART1 的非阻塞输出实现。

#### 3.12.1 模式定义

| 模式 | 命令字符 | LCD 方向 | 显示内容 |
|---|---|---|---|
| `DISP_MODE_CAMERA` | `'C'` / `'c'` | 1 (横屏 90°) | 240×240 摄像头画面居中, 左右各 40px 留白 |
| `DISP_MODE_WEATHER` | `'W'` / `'w'` | 3 (横屏 270°) | 320×240 全屏天气仪表板 |

> 两种模式之间相对旋转 180°, 物理屏幕在横屏放置时无论哪个方向朝上都正向显示一种内容。

#### 3.12.2 数据结构与 API

```c
/* Task/display_mode.h */
typedef enum {
    DISP_MODE_CAMERA = 0,
    DISP_MODE_WEATHER = 1,
} DisplayMode_t;

extern volatile DisplayMode_t g_display_mode;

void DisplayMode_Request(DisplayMode_t mode);                 /* ISR 安全 */
int  DisplayMode_TakePending(DisplayMode_t *out_mode);        /* 仅 LVGL 任务调用 */
void DisplayMode_StartUart1Rx(void);                          /* main.c 中 USART1_Init() 后调用 */
void USART1_IRQ_Handler(void);                                /* 由 stm32h7xx_it.c 转发 */
```

#### 3.12.3 切换流程

```
USART1 RX ('C' / 'W')
  └→ USART1_IRQHandler → USART1_IRQ_Handler
       └→ process_rx_byte → DisplayMode_Request(mode)
            └→ 设置 s_pending_flag/s_pending_mode (volatile)

DisplayTask 主循环 (100ms, 原 Weather_Task)
  └→ DisplayMode_TakePending(&pending)
       └→ Weather_ApplyMode(pending)
            ├→ LCD_direction(1 或 3)
            ├→ lv_obj_add/clear_flag(canvas, HIDDEN)
            ├→ lv_obj_add/clear_flag(weather_panel, HIDDEN)
            └→ lv_obj_invalidate(lv_scr_act())  ← 强制整屏重绘
```

> ISR 只设置请求标志, **不直接调用 LVGL API**, 保证 LVGL 单线程访问规则。

#### 3.12.4 Camera_task 配合

- DCMI / DMA 始终连续运行 (避免重启硬件代价)
- 通过 `g_cam_canvas` 全局对象由 DisplayTask 控制 hidden
- Camera_task 内只在 `g_display_mode == DISP_MODE_CAMERA` 时才 `memcpy` + `lv_obj_invalidate(canvas)`,
  天气模式下减少 LVGL 工作量

#### 3.12.5 USART1 非阻塞 printf (TX)

**为什么需要重写 fputc:**
- 原始 fputc 调用 `HAL_UART_Transmit(huart1, ..., 100ms)`, 是阻塞调用
- 多任务并发 printf 时 HAL 的 `gState` 互斥保护不可靠 (任务被高优先级抢占可能导致 gState 卡在 BUSY_TX)
- 表现为: 发送某个字符 / 收到 MQTT 消息后串口完全卡死, printf 不再输出

**新实现 (`Task/display_mode.c` 中的 fputc):**
- 2KB 静态环形缓冲 `tx_ring[2048]` (大小为 2 的幂, 用 `&` 取模)
- 任务调 printf → fputc 把字节写入 `tx_ring`, 立即返回 (微秒级)
- 写入时使能 USART1 的 TXE 中断 (`USART_CR1_TXEIE_TXFNFIE`)
- 短临界区 (`__disable_irq` + 改 head + `__enable_irq`) 保护多任务并发
- 自动 `\n` → `\r\n` 转换 (省得用户每条 printf 都写 `\r\n`)
- 缓冲满时丢弃字节 (不阻塞调用者), 不会导致死锁

**TX 中断 ISR 路径:**
```
USART1 TXE 触发
  └→ USART1_IRQ_Handler
       ├→ if (RXNE) 处理命令字符 (RX 路径)
       ├→ if (TXE && tx_head != tx_tail)
       │     └→ TDR = tx_ring[tx_tail]; tx_tail++
       └→ if (tx_head == tx_tail) 关闭 TXE 中断 (避免空转)
```

**RX 路径:**
- 直接寄存器级使能 `USART_CR1_RE` + `USART_CR1_RXNEIE_RXFNEIE`
- **不**调用 `HAL_UART_Receive_IT` (该函数会和 fputc 的 huart1 状态机冲突)
- 自定义 `USART1_IRQHandler` 直接读 `USART1->RDR`, 处理 `'C'`/`'W'` 命令
- 错误标志 (ORE/FE/NE/PE) 在 ISR 中清掉, 防止反复触发

**踩坑记录:**
1. **HAL 状态机冲突**: 同时用 `HAL_UART_Receive_IT` (RX) + 阻塞 `HAL_UART_Transmit` (TX) 在多任务下不可靠, 必须绕开 HAL 状态机直接操作寄存器。
2. **USART_CR1 位**: STM32H7 用 `USART_CR1_RXNEIE_RXFNEIE` (FIFO 架构), 不是 F1/F4 的 `USART_CR1_RXNEIE`。
3. **PA10 浮空检测**: 初版调试时遇到 PA10 一直为 0, 通过临时配置 INPUT+NOPULL/PULLUP/PULLDOWN 三种模式读电平, 准确判断接线问题。该自测代码已移除。
4. **fputc 多重定义**: 旧 fputc 在 `Drivers/User/Src/usart.c` 里, 新的在 `Task/display_mode.c`。旧的已用 `#if 0` 注释禁用, 避免链接器多重定义错误。
5. **环形缓冲大小**: 必须是 2 的幂 (用 `&` 替代 `%` 提速), 当前 2048 字节足以应付 ESP-01 触发的 `print_weather_info` (9 行 printf, 约 200 字节) 突发输出。

---

## 四、工程问题与解决日志

### 问题 1: LVGL lv_draw_sw 链接错误

**现象:** 链接阶段报 `Undefined symbol lv_draw_sw_init_ctx / lv_draw_sw_deinit_ctx / lv_draw_sw_transform`

**定位:** 检查编译输出，发现 `lv_draw_sw.c` 等文件未出现在编译列表中。

**原因:** Keil 工程文件 (`.uvprojx`) 中 LVGL 源文件路径错误。工程使用扁平路径 `..\LVGL\src\lv_draw_sw.c`，但 LVGL v8 实际目录结构为 `LVGL/src/draw/sw/lv_draw_sw.c`。

**解决:** 修正 `.uvprojx` 中所有 `lv_draw_sw_*.c` 的 `<FilePath>` 为:
```xml
<FilePath>..\LVGL\src\draw\sw\lv_draw_sw.c</FilePath>
```

**验证:** 修正后文件可被编译器找到并编译。

---

### 问题 2: LCD_WriteDataBuffer 未定义

**现象:** 链接报错 `Undefined symbol LCD_WriteDataBuffer`

**定位:** `lv_port_disp.c` 中调用了 `LCD_WriteDataBuffer()`，但该函数在 LCD 驱动中不存在。

**原因:** LVGL 显示端口移植时新增了该函数调用，但忘记在 `lcd.c` 中实现。

**解决:** 在 `LCD/lcd.c` 中实现 `LCD_WriteDataBuffer()`，功能为在窗口已设置的前提下批量写入像素数据:
```c
void LCD_WriteDataBuffer(uint16_t *pBuf, uint32_t pixel_count)
{
    // 发送 GRAM 写命令后，分批通过 SPI 发送像素数据
}
```
同时在 `lcd.h` 中添加函数声明。

**验证:** 编译通过，无链接错误。

---

### 问题 3: lv_conf.h 找不到 (lv_draw_sw 编译错误)

**现象:** `lv_draw_sw.c` 编译时报 `cannot open source input file "../../lv_conf.h"`

**定位:** `lv_conf_internal.h` 使用相对路径 `#include "../../lv_conf.h"`，该路径相对于 `LVGL/src/` 目录解析为 LVGL 上级目录。但从 `LVGL/src/draw/sw/` 编译时，相对路径解析错误。

**原因:** LVGL 默认假设 `lv_conf.h` 放在 `lvgl` 文件夹的同级目录。本项目将 `lv_conf.h` 放在 `LVGL/` 内部，路径不匹配。

**解决方案 (二选一):**

方案 A — 在编译器 Define 中添加 `LV_CONF_INCLUDE_SIMPLE`，并将 `../LVGL` 加入 Include Path:
```
Define: USE_HAL_DRIVER,STM32H723xx,LV_CONF_INCLUDE_SIMPLE
IncludePath 新增: ..\LVGL
```

方案 B — 将 `lv_conf.h` 移动到 `LVGL` 文件夹的上一级目录 (即项目根目录)。

**验证:** 待实施后重新编译验证。

---

### 问题 4: LVGL 所有源文件路径错误

**现象:** Rebuild 后大量 LVGL 文件报 `cannot open source input file`，包括 core、draw、hal、misc 等模块。

**定位:** `.uvprojx` 中所有 LVGL 文件使用扁平路径 (如 `..\LVGL\src\lv_obj.c`)，但 LVGL v8.3.11 的实际目录结构为分层结构。

**原因:** 工程文件可能是从旧版 LVGL (v7 扁平结构) 模板生成，未适配 v8 的目录结构。

**正确路径映射:**

| 模块 | 错误路径 | 正确路径 |
|---|---|---|
| core | `..\LVGL\src\lv_obj.c` | `..\LVGL\src\core\lv_obj.c` |
| draw | `..\LVGL\src\lv_draw.c` | `..\LVGL\src\draw\lv_draw.c` |
| draw/sw | `..\LVGL\src\lv_draw_sw.c` | `..\LVGL\src\draw\sw\lv_draw_sw.c` |
| hal | `..\LVGL\src\lv_hal_disp.c` | `..\LVGL\src\hal\lv_hal_disp.c` |
| misc | `..\LVGL\src\lv_mem.c` | `..\LVGL\src\misc\lv_mem.c` |
| font | `..\LVGL\src\lv_font.c` | `..\LVGL\src\font\lv_font.c` |
| widgets | `..\LVGL\src\lv_btn.c` | `..\LVGL\src\widgets\lv_btn.c` |
| porting | `..\LVGL\lv_port_disp.c` | `..\LVGL\examples\porting\lv_port_disp.c` |

**解决:** 需要重写 `.uvprojx` 中 `LVGL_src` 和 `LVGL_porting` 组的所有文件路径，同时删除不存在的 GPU 后端文件 (SDL、VGLite、PXP、ARM2D 等)。

**验证:** 待完成路径修正后重新编译。

---

### 问题 5: DCache 一致性

**现象:** (潜在问题) DMA 写入帧缓冲后 CPU 读取到旧数据。

**定位:** DMA 直接写入 AXI SRAM，CPU 通过 DCache 读取可能命中缓存中的旧数据。

**原因:** DMA 传输绕过 CPU Cache，导致 Cache 与内存不一致。

**解决:** 每帧 DMA 完成后调用:

```c
SCB_InvalidateDCache_by_Addr((uint32_t *)Camera_Buffer, Display_Width * Display_Height * 2);
```

**验证:** 已在 `Camera_task` 中实现，图像显示正常无花屏。

---

### 问题 6: SPI DMA 导致 DCMI 完全不工作 ⭐ 重要

**现象:** 改用 SPI DMA 传输后，DCMI_FrameState 始终为 0，Camera_Buffer 无任何数据，屏幕无显示。

**定位:** Keil Debug 观察变量，发现 Camera_task 卡死在 `LCD_Init()` → `LCD_Clear()` → `LCD_DMA_Wait()` 中，`DCMI_OV2640_Init()` 从未被执行。

**原因:** STM32H7 的 **DTCM RAM (0x20000000) 不能被 DMA1/DMA2 访问**！Scatter file 将所有 RW/ZI 数据放在 DTCM，导致 `lcd_dma_buf` 在 DTCM 中。DMA1 从 DTCM 读数据时静默失败，`HAL_SPI_TxCpltCallback` 永远不触发，`lcd_dma_busy` 卡在 1，`LCD_DMA_Wait()` 死循环。

**解决:**
1. DMA 缓冲区使用 `__attribute__((section(".ARM.__at_0x24040000")))` 强制放到 AXI SRAM
2. Scatter file 添加 AXI SRAM 执行区域:
```
RW_AXIRAM 0x24040000 0x00010000 {
    *(.ARM.__at_0x24040000)
}
```
3. `LCD_DMA_Wait()` 增加超时保护
4. 添加 `HAL_SPI_ErrorCallback` 防止错误时死锁
5. 添加 SPI1_IRQHandler 处理 HAL DMA 使能的 SPI 错误中断

**验证:** 修改后摄像头采集和 LCD DMA 刷屏均正常工作。

**教训:** 在 STM32H7 上使用 DMA 时，必须确认缓冲区所在的内存区域是否可被 DMA 访问。DTCM 仅 CPU 可访问，DMA 缓冲区必须放在 AXI SRAM、SRAM1~3 等 DMA 可达区域。

### 问题 7: USART1 RX 命令通道移除后, 串口不接时摄像头只采一帧 ⭐ 重要

**现象:** 移除 USART1 RX 命令切换界面功能后 (`DisplayMode_StartUart1Rx()` 改为关闭 RE/NVIC), 复位时串口不接线, 摄像头只采集一帧就卡住; 复位时串口插着则一切正常, 拔掉后续也正常。

**定位:**
1. 现象与串口物理连接强相关: 复位时 PA10 (RX) 悬空 → 异常; PA10 被外部驱动 → 正常
2. 注释掉 `main.c` 中 `DisplayMode_StartUart1Rx()` 调用后, 无论串口是否连接, 摄像头均正常
3. `DisplayMode_StartUart1Rx()` 在 `vTaskStartScheduler()` 之前调用, 此时 FreeRTOS 尚未接管中断系统

**原因:**

`USART1_Init()` 调用 `HAL_UART_Init()` 时使能了接收器 (RE=1)。当串口未连接时, PA10 (RX) 悬空 (内部上拉), 噪声导致 USART1 接收器不断"接收"垃圾数据, 设置 FE (帧错误) / NE (噪声错误) 标志。

随后 `DisplayMode_StartUart1Rx()` 在接收器处于错误接收状态时执行 `USART1->CR1 &= ~USART_CR1_RE` 强制关闭接收器。STM32 参考手册明确指出 **"RE bit should not be disabled during reception"** (接收过程中不应关闭 RE)。在噪声引起的错误接收状态下关闭 RE, 可能导致 USART1 外设进入异常状态, 在 APB1 总线上产生短暂卡顿。

该 APB1 总线卡顿发生在 FreeRTOS 调度器启动之前, 可能干扰了 NVIC 中断控制器的初始状态。当 `vTaskStartScheduler()` 启动后, DCMI/DMA 中断链 (DMA2_Stream7 TC → DCMI_DMAXferCplt → 使能 DCMI_IT_FRAME → FRAME IT → 回调) 依赖的中断状态已经不对, 导致第一帧之后 DMA TC 中断不再触发:

```
DMA TC (第1次) → DCMI_DMAXferCplt → 使能 FRAME IT → 回调 → DCMI_FrameState=1 ✓
DMA TC (第2次) → 不触发 → DCMI_IT_FRAME 不再使能 → DCMI_FrameState 永远为 0 ✗
```

**串口插着时为什么正常:** PA10 被外部 USB-串口适配器干净驱动 (持续高电平空闲), 无噪声, 无错误标志, 关闭 RE 时接收器处于空闲状态, 不会产生异常。

**解决:**
1. 移除 USART1 RX 命令切换界面功能 (`process_rx_byte` 改为空函数)
2. 注释掉 `main.c` 中 `DisplayMode_StartUart1Rx()` 调用 — 该函数在调度器启动前修改 USART1 寄存器, 可能干扰 NVIC 状态
3. 不调用该函数后, USART1 RX 保持 `HAL_UART_Init` 后的默认状态:
   - RE=1 (接收器开着, 但无害)
   - RXNEIE=0 (RXNE 中断未使能, 噪声不会触发中断)
   - NVIC 未使能 (USART1 中断不进入 CPU)
4. 显示模式切换改为仅通过 `DisplayMode_Request()` API (按钮回调) 完成

**验证:** 修改后, 无论串口是否连接, 摄像头均连续正常采集, 界面切换仅通过按钮触发。

**教训:**
1. **不要在 `vTaskStartScheduler()` 之前修改外设中断相关寄存器** (特别是 NVIC ICER/ISER), 此时 FreeRTOS 尚未配置完整的中断优先级体系, 可能产生不可预期的副作用
2. **不要在接收器活跃时关闭 RE 位**, 参考手册明确禁止此操作; 应先确保接收器空闲 (RXNE=0, 无错误标志) 再关闭
3. **悬空引脚的噪声不仅是软件问题**, 噪声导致的 USART 错误状态会改变外设内部状态机, 关闭外设时的行为因此不同
4. 移除某功能时, 如果初始化函数仅服务于该功能, 应同时移除调用点, 而非保留一个"什么都不做但可能产生副作用"的空壳

---

## 五、版本与发布记录

### V1.0 (初始版本)

**功能:**
- OV2640 摄像头 RGB565 采集 (240×240 裁剪显示)
- DCMI + DMA2 连续传输模式
- ILI9341 LCD SPI1 + DMA1 加速显示 (ping-pong 双缓冲)
- FreeRTOS 多任务架构
- LVGL v8.3.11 GUI 框架集成

### V1.1 (传感器集成)

**新增功能:**
- AHT20 温湿度传感器驱动 (软件 I2C, 地址 0x38)
- BH1750FVI 光照传感器驱动 (软件 I2C, 地址 0x23)
- 统一传感器采集任务 (1s 周期, 两传感器顺序读取, 无需互斥)
- LVGL 环境数据显示 (温度/湿度/光照, 屏幕底部 80px 区域)
- 数据过期检测 (3s 超时显示离线)
- PB-03F BLE 蓝牙模块集成 (从机 MPU6050 数据透传)

**修复:**
- AHT20 I2C 读取协议修正 (直接读取, 不发寄存器地址)
- 湿度计算 32 位溢出修复 (改用 uint64_t 中间运算)
- 传感器独立初始化 (任一不在线不影响另一个)

### V1.2 (网络天气数据集成)

**新增功能:**
- ESP-01 WiFi 模块通过 USART3 (PD8/PB11, 115200) 接收 MQTT 透传 JSON 天气数据
- USART3 + DMA1_Stream1 + IDLE 中断的变长帧接收方案
- cJSON 解析天气 JSON (city/temp/humi/feel/cond/wind/wdir/pres/time)
- LVGL 屏幕底部右侧显示城市/温度/湿度
- USART1 调试通道输出原始 JSON 和解析后的结构化数据

**修复:**
- USART3 DMA 缓冲区强制放到 AXI SRAM (0x24040800), 解决 DTCM 不可被 DMA 访问导致的接收失败
- 添加 SCB_InvalidateDCache_by_Addr 解决 DCache 一致性问题
- 中断优先级调整为 6 (高于 FreeRTOS configLIBRARY_MAX_SYSCALL_INTERRUPT_PRIORITY=5)

**已知限制:**
- I2C 总线无互斥保护 (当前不需要, 因为所有 I2C 设备在同一任务中顺序访问)
- BH1750 驱动中 `BH1750_MeasureOnce()` 使用 `HAL_Delay`, 在 FreeRTOS 任务中不安全 (已规避, 不调用该函数)
- MPU6050 驱动文件仍在本地 (`Communication/MPU6050.c`), 但实际 MPU6050 在从机端通过蓝牙传输

### V1.3 (横屏显示 + 模式切换 + 非阻塞 printf)

**新增功能:**
- 横屏显示 (LCD 方向 1 / 3, 横屏 320×240)
- 运行时显示模式切换 (`Task/display_mode.c`):
  - USART1 接收 `'C'` → 摄像头模式 (LCD 方向 1, 240×240 居中)
  - USART1 接收 `'W'` → 天气模式 (LCD 方向 3, 320×240 全屏, 相对摄像头模式 180° 翻转)
- 重新设计的 LVGL 天气仪表板 (Material Dark 风格):
  - 左列 Hero 卡: 城市 / 大字号温度 (Montserrat 28pt) / 状况 / 体感 / 三列详情 (湿度/风/气压)
  - 右列 INDOOR 卡: 三行本地传感器 (温度/湿度/光照, 大字号显示)
- 启用 LVGL Montserrat 20pt 与 28pt 字体
- USART1 fputc 重写为环形缓冲 + TXE 中断驱动的非阻塞实现, 修复多任务并发 printf 死锁

**修复:**
- 解决发送 `'W'` 或 ESP-01 推送大量 printf 时 USART1 完全卡死的问题
- LCD 方向切换后强制 `lv_obj_invalidate(lv_scr_act())`, 让 LVGL 整屏重绘匹配新方向
- USART1 RX/TX 绕开 HAL 状态机, 直接寄存器级操作, 避免 HAL gState 冲突

**新增文件:**
- `Task/display_mode.c` / `display_mode.h` (模式切换 + 非阻塞 fputc + USART1 IRQ 处理)

### V1.5 (从机指令协议 + 在位校验时机修正 + 姿态评分增强)

**新增功能:**
- **主机 → 从机单字符指令协议 (`A`/`Z`/`S`)** 取代原 JSON `{"cmd":...}`:
  - 驱动层 `UART_ESP32_SendBytes()` / `UART_ESP32_SendByte()` (TX 与 RX DMA 互不干扰, 阻塞发送)
  - 业务层 `Slave_SendCmd()` / `Slave_StartReceive()`('A') / `Slave_StopReceive()`('Z') / `Slave_Sleep()`('S'), 协议宏 `SLAVE_CMD_START/STOP/SLEEP`
  - `StateTask`: 确认时长进入 LEARNING 发 `'A'`, 暂停 (PAUSED) 与学习结束 (SUMMARY) 发 `'Z'`, `'S'` 休眠预留
- **学习界面 DBG 面板新增 `Po` / `Pr`** 两行 (从机刚接收到的原始姿态分数 / 压力值, 走 `Slave_GetLatest()`)
- **UART 原始接收调试开关**: `UART_ESP32.c` 的 `ESP32_RX_DEBUG` 与 `UART_ESP01.c` 的 `ESP01_RX_DEBUG`, 置 1 时每帧 IDLE 收到即通过 USART1 (printf) 打印原始内容 (排查"收不到/解析不到"用, 排查完置 0)

**行为修正:**
- **在位校验时机**: 原来在点 Start (`GUI_START`) 时就判断压力, 导致第二次进入被"Please sit on chair"拦下。
  现改为点 Start **直接进入 PICKING 选时长**, 在**确认时长 (`CONFIRM_DURATION`)** 时才校验在位;
  没人则提示并退回 IDLE。同时确认时正确应用 Picker 选中的分钟数到 `s_target_minutes`。
- **姿态评分 `score_posture`**: 由"仅用从机 score"改为综合 `score + state + pressure`——
  压力 < 5.0 视为离座直接 0 分; `state` 含 absent/away→0、distract→×0.6、fatigue/tired→×0.5; 计入坐姿 30% 权重。

**影响文件:**
- `Communication/UART_ESP32.{c,h}`, `Task/SlaveRxTask.{c,h}`, `Task/StateTask.{c,h}`, `Task/FusionTask.c`, `Task/LearningScreen.c`, `Communication/UART_ESP01.c`

**注意:**
- 若未接真实压力传感器 (pressure 恒为 0), 确认时长会被判"没人"而退回, 且姿态分恒为 0; 调试时可临时放宽 `score_posture` / `CONFIRM_DURATION` 的压力门控。

---

## 六、待办事项

- [x] 修正 `.uvprojx` 中所有 LVGL 文件路径 (适配 v8 目录结构)
- [x] 添加 `LV_CONF_INCLUDE_SIMPLE` 编译宏
- [x] 将 `../LVGL` 加入 Keil Include Path
- [x] 删除工程中不需要的 GPU 后端文件 (SDL/VGLite/PXP/ARM2D/DMA2D)
- [x] 完善 LVGL 心跳驱动 (TIM7, 1ms 中断, `SYSTEM/TIM.c`)
- [x] 完善 LVGL 显示驱动对接，验证 GUI 刷新
- [x] 将 `.\SYSTEM` 加入 Keil Include Path, 将 `SYSTEM/TIM.c` 添加到工程源文件组
- [x] AHT20 温湿度传感器驱动 + LVGL 显示
- [x] BH1750 光照传感器驱动 + LVGL 显示
- [x] 统一传感器采集任务 (AHT20 + BH1750 顺序读取)
- [x] 数据过期检测 + 时间戳校验
- [x] ESP-01 USART3 接收 + cJSON 解析 (DMA + IDLE 中断)
- [x] LVGL 显示城市 + 远程温湿度
- [x] LCD 横屏显示 + 摄像头/天气运行时模式切换 (USART1 命令)
- [x] USART1 非阻塞 printf (环形缓冲 + TXE 中断)
- [ ] 蓝牙数据接收解析 (PB-03F UART 透传 MPU6050 数据)
- [ ] MPU6050 姿态数据 LVGL 显示
- [ ] 优化 SPI DMA 传输 (考虑 16-bit 数据宽度避免 CPU 字节序转换)
- [ ] 优化 SPI DMA 传输提升刷屏帧率
- [ ] 添加 JPEG 模式支持 (高分辨率传输)

---

## 七、系统架构总览

```
┌────────────────────────────────────────────────────────────────────┐
│                      STM32H723ZGT6 (主机)                            │
├────────────────────────────────────────────────────────────────────┤
│                                                                    │
│  ┌──────────┐ ┌──────────┐ ┌──────────┐ ┌────────┐ ┌────────────┐│
│  │LVGL_Task │ │Camera_   │ │AHT20_    │ │Weather_│ │Weather_    ││
│  │(5ms)     │ │task      │ │Task      │ │Task    │ │RxTask      ││
│  │lv_timer  │ │DCMI采集  │ │传感器    │ │LVGL    │ │ESP-01+JSON ││
│  │_handler  │ │+canvas   │ │1s采集    │ │+模式切换│ │            ││
│  └──────────┘ └────┬─────┘ └────┬─────┘ └───┬────┘ └─────┬──────┘│
│                    │            │           │             │       │
│                    │     xSensorDataQueue   │             │       │
│                    │     ───────────────────►            │       │
│                    │                        │             │       │
│                    │                        ◄ xWeatherQueue       │
│                    │                                                │
│   ┌────────────────┴──── 模式切换 ──────────────┐                  │
│   │ display_mode.c: 'C'/'W' → 切 LCD 方向 + UI │                  │
│   └─────────────▲────────────────────────────────┘                 │
│                 │ ISR: USART1 RX                                   │
│                                                                    │
│  ┌─────────────────────────────────────────────────────────────┐  │
│  │                       硬件外设层                              │  │
│  ├──────────┬─────────┬─────────┬─────────┬──────────┬────────┤  │
│  │SPI1+DMA  │ DCMI    │SoftI2C  │USART1   │USART3    │TIM7    │  │
│  │(LCD)     │+DMA2    │PB8/PB9  │PA9/PA10 │PD8/PB11  │1ms tick│  │
│  │          │         │         │+TX环缓冲│+RX DMA   │        │  │
│  └────┬─────┴────┬────┴────┬────┴────┬────┴────┬─────┴────────┘  │
│       │          │         │         │         │                  │
└───────┼──────────┼─────────┼─────────┼─────────┼──────────────────┘
        │          │         │         │         │
   ┌────▼───┐ ┌───▼────┐ ┌──▼────┐ ┌─▼─────┐ ┌─▼────┐
   │ILI9341 │ │OV2640  │ │AHT20  │ │串口    │ │ESP-01│
   │LCD     │ │Camera  │ │+      │ │助手    │ │WiFi  │
   │320×240 │ │240×240 │ │BH1750 │ │(命令+  │ │(MQTT │
   │横屏    │ │        │ │       │ │日志)   │ │天气) │
   └────────┘ └────────┘ └───────┘ └────────┘ └──────┘

   还有 PB-03F BLE 接收从机 MPU6050 数据 (UART 透传, 待实现)
```

**I2C 总线设备 (PB8=SCL, PB9=SDA):**

| 设备 | 7-bit 地址 | 说明 |
|---|---|---|
| AHT20 | 0x38 | 温湿度传感器 |
| BH1750FVI | 0x23 | 光照传感器 (ADDR=GND) |

> 两设备在同一任务中顺序访问，无需互斥锁。
> MPU6050 不在本机 I2C 总线上 (从机端通过蓝牙透传)。

---

## 十一、重构记录 (V1.4 — UART 驱动业务分层 + 任务命名规范)

### 11.1 背景

V1.3 之前的代码存在两个分层问题:

1. **UART 接收逻辑与业务解析混杂**: `Sensor/UART.c` 同时承担 USART3 底层驱动 (DMA + IDLE) 和天气 JSON 解析、队列发布、调试打印。新增 ESP32 BLE 链路时，再写一份类似但又不同的代码会带来重复。
2. **任务文件名与职责不匹配**: `Task/WeatherTask.c` 是 LVGL 仪表板渲染任务，与"天气数据接收"在概念上是两件事; `LCD/touch_test.c` 名字像测试代码，实际上是触摸驱动主任务。

### 11.2 重构策略

**UART 类业务统一拆成驱动层 + 业务层:**

| 链路 | 驱动层 (`Communication/`) | 业务层 (`Task/`) |
|---|---|---|
| ESP-01 WiFi (USART3) | `UART_ESP01.{c,h}` 分帧 | `WeatherTask.{c,h}` 解析 + 队列 + 消费 API |
| ESP32 BLE (USART2) | `UART_ESP32.{c,h}` 分帧 | `SlaveRxTask.{c,h}` 解析 + 队列 + 消费 API |

驱动层 API 模板:
```c
void  USARTx_Init(void);
void  USARTx_IRQ_Handler(void);
void  UART_xxx_BindRxTask(TaskHandle_t handle);
int   UART_xxx_TakeFrame(uint8_t *buf, uint16_t max_len, uint16_t *out_len);
void  UART_xxx_GetStats(uint32_t *recv, uint32_t *drop);
```

业务层消费 API 风格:
```c
int  Xxx_GetLatest(XxxData_t *out);                       /* 非阻塞 peek */
int  Xxx_WaitNew(XxxData_t *out, TickType_t timeout);    /* 阻塞 receive */
void Xxx_GetStats(uint32_t *recv, uint32_t *drop, uint32_t *parse_err);
```

新增 UART 链路按此模板复制即可。

**LVGL 显示任务从 WeatherTask 拆分独立**: 渲染逻辑迁移到 `Task/Display.c::DisplayTask`, 数据通过消费 API 拉取，不再直接访问全局队列。

**触摸任务按统一风格命名**: `LCD/touch_test.{c,h}` → `Task/TouchTask.{c,h}`, `TouchTest_*` API 重命名为 `Touch_*`。

### 11.3 文件层面变更

| 操作 | 文件 |
|---|---|
| 新建 | `Communication/UART_ESP01.{c,h}` (USART3 底层) |
| 新建 | `Communication/UART_ESP32.{c,h}` (USART2 底层) |
| 重写 | `Task/WeatherTask.{c,h}` (变为天气接收业务层) |
| 新建 | `Task/SlaveRxTask.{c,h}` (从机 BLE 数据接收业务层) |
| 新建 | `Task/Display.{c,h}` (原 WeatherTask 的 LVGL 部分) |
| 新建 | `Task/TouchTask.{c,h}` (原 `LCD/touch_test.*`) |
| 删除 | `Sensor/UART.{c,h}` (拆分到 UART_ESP01 + WeatherTask) |
| 删除 | `LCD/touch_test.{c,h}` (改名搬位) |
| 修改 | `Core/Src/freertos.c` (任务列表更新, include 调整) |
| 修改 | `Core/Src/stm32h7xx_it.c` (新增 USART2 / DMA1_Stream3 派发, USART3 派发改用 huart3.hdmarx) |
| 修改 | `MDK-ARM/STM32H723.uvprojx` (源文件列表同步) |

### 11.4 任务命名映射

| 旧名称 | 新名称 | 说明 |
|---|---|---|
| `Weather_Task` (LVGL UI) | `DisplayTask` | LVGL 仪表板任务, 在 `Task/Display.c` |
| `Weather_RxTask` | `Weather_RxTask` | 不变, 但实现迁到 `Task/WeatherTask.c` (天气数据接收) |
| 无 | `Slave_RxTask` | 新增, 接收 ESP32 BLE 透传 IMU + 压力 |
| `TouchTest_Task` | `Touch_Task` | 在 `Task/TouchTask.c` |
| `TouchTest_Start()` | (已移除) | 改为 `xTaskCreate(Touch_Task, ...)` 直接创建 |
| `AHT20_Task` | `Sensor_Task` | 升级为聚合 AHT20 + BH1750 + MAX9814 |

### 11.5 中断派发变化

`stm32h7xx_it.c` 的 USART3 派发改写为通过 `huart3.hdmarx` 访问 DMA 句柄, 不再 extern 一份 `hdma_usart3_rx`:

```c
extern UART_HandleTypeDef huart3;
extern void USART3_IRQ_Handler(void);

void USART3_IRQHandler(void)        { USART3_IRQ_Handler(); }
void DMA1_Stream1_IRQHandler(void)
{
    if (huart3.hdmarx != NULL) HAL_DMA_IRQHandler(huart3.hdmarx);
}
```

USART2 / DMA1_Stream3 沿用同一模式。

### 11.6 AXI SRAM 重新分配

新增 USART2 接收和 MAX9814 麦克风后, AXI SRAM 已用区段:

| 起址 | 大小 | 用途 |
|---|---|---|
| 0x24000000 | 115.2KB | Camera DCMI 帧缓冲 |
| 0x24040000 | 2KB | LCD SPI ping-pong |
| 0x24040800 | 256B | USART3 RX (ESP-01) |
| 0x24040900 | 1KB | MAX9814 ADC 循环 |
| 0x24040D00 | 256B | USART2 RX (ESP32 BLE) |
| 0x24040E00 | (空闲) | 新增 DMA 缓冲从此起, 32 字节对齐 |

### 11.7 DMA Stream 占用 (重构后)

| Stream | 用途 |
|---|---|
| DMA1_Stream0 | SPI1 TX (LCD) |
| DMA1_Stream1 | USART3 RX (ESP-01) |
| DMA1_Stream2 | ADC2 (MAX9814) |
| DMA1_Stream3 | USART2 RX (ESP32 BLE) |
| DMA2_Stream7 | DCMI (OV2640) |

新增 DMA 链路必须挑空闲 stream 并同步本节表格。

### 11.8 验证清单

- [x] 编译通过 (Keil MDK V5, ARMCC v5)
- [x] FreeRTOS 任务全部启动, USART1 输出 `[UART2/UART3] Init OK`
- [x] ESP-01 接收链路保持原行为
- [x] ESP32 BLE 接收链路新增可用
- [x] LVGL 仪表板与触摸功能不受影响
- [x] 中断优先级仍满足 FreeRTOS configLIBRARY_MAX_SYSCALL_INTERRUPT_PRIORITY=5

### 11.9 后续维护建议

1. 新增 UART 接收链路: 拷贝 `Communication/UART_ESP01.*` 改名 + 选空闲 DMA stream + 更新 AXI SRAM 表
2. 新增业务任务: 拷贝 `Task/SlaveRxTask.*` 改名, 替换 JSON 解析逻辑
3. 新模块统一 UTF-8 (with BOM) 编码, 中文注释保持 Doxygen 风格
4. `Camera_task / DisplayTask` 这两个历史命名暂不强制改名, 新模块按 `<前缀>_Task` 风格命名
