luruicheng891/Study-Focus-Meter/项目架构.md

# AI智能学习状态全方位监测系统 —— 项目总体架构总结

------

---

## 软件开发内容

### 1. 底层驱动实现

- [x] DCMI + DMA 驱动 —— OV2640图像采集
- [x] I2C 驱动 —— BH1750、AHT20
- [ ] 麦克风ADC采集 —— 环境噪音检测
- [x] WiFi AT指令驱动 —— 天气API请求
- [ ] BLE串口通信驱动 —— 与nRF52832通信

### 2. 图像预处理流水线

- [ ] ROI人脸区域裁剪
- [ ] 灰度化转换
- [ ] 缩放到32x32
- [ ] 归一化处理（根据模型要求）

### 3. CubeAI模型

- [ ] 数据集准备（专注/分心/疲劳三类图片）
- [ ] 模型训练（轻量CNN）
- [ ] 模型转换（转为CubeAI格式）
- [ ] 部署到STM32H7
- [ ] 推理代码编写

### 4. nRF52832从机程序

- [ ] MPU6050驱动（含Motion Interrupt唤醒）
- [ ] 压力传感器ADC采集
- [ ] BLE服务创建（姿态数据 + 压力状态）
- [ ] 低功耗睡眠/唤醒逻辑
- [ ] 数据打包发送

### 5. FreeRTOS任务

- [x] CameraTask —— 摄像头帧采集
- [ ] PreprocessTask —— 图像预处理
- [ ] AITask —— CubeAI推理
- [x] SensorTask —— 环境传感器读取
- [ ] BLETask —— 接收椅子数据
- [ ] FusionTask —— 多模态融合计算
- [x] GUITask —— LVGL界面刷新
- [x] NetworkTask —— 天气数据获取

### 6. 多模态融合算法

- [ ] 时间戳对齐缓冲区
- [ ] AI视觉置信度 → 专注分项(0-100)
- [ ] 坐姿数据 → 坐姿分项(0-100)
- [ ] 环境数据 → 环境分项(0-100)
- [ ] 学习时长 → 时长分项(0-100)
- [ ] 加权融合：40% + 30% + 20% + 10%
- [ ] 最终专注度评分输出

### 7. LVGL界面

**主界面：**
- [ ] 当前时间日期
- [x] 天气信息显示
- [ ] 专注度圆环/进度条
- [ ] 坐姿状态指示
- [ ] 环境评分显示
- [ ] 学习时长计时器
- [ ] AI建议文字区

**设置界面：**
- [ ] 坐姿标定
- [ ] 学习时长提醒阈值

**调试界面（需进入调试模式）：**
- [ ] 摄像头实时画面
- [ ] 各传感器原始数据

### 8. 系统状态机

- [ ] IDLE状态 —— 等待用户
- [ ] READY状态 —— 压力检测到人，等待开始
- [ ] LEARNING状态 —— 全系统运行，持续监测
- [ ] PAUSED状态 —— 暂停监测
- [ ] SUMMARY状态 —— 学习结束，显示统计

---

## 三、开发顺序

### 第一阶段（闭环验证）
- [x] OV2640 + LCD 基础显示
- [ ] 图像预处理流水线
- [ ] CubeAI模型训练+部署
- [ ] 专注/分心/疲劳识别
- [ ] GUI显示AI结果

### 第二阶段（环境监测）
- [x] BH1750、AHT20、麦克风驱动
- [x] SensorTask任务
- [ ] 环境评分子模块
- [ ] GUI环境信息显示

### 第三阶段（无线椅子节点）
- [ ] nRF52832 + MPU6050 + 压力传感器驱动
- [ ] BLE通信链路打通
- [ ] BLETask任务
- [ ] 坐姿评分子模块
- [ ] GUI坐姿状态显示

### 第四阶段（融合+完善）
- [ ] 多模态融合算法
- [x] 天气API接入
- [ ] 学习时长统计
- [ ] 系统状态机
- [ ] UI完整优化
- [ ] 整体联调测试

# 一、项目定位

本项目是一个：

```text
基于 STM32H7 的多模态边缘AI学习状态感知系统
```

系统融合：

- AI视觉分析
- 姿态检测
- 环境监测
- 无线低功耗IoT节点
- FreeRTOS实时系统
- LVGL图形界面

用于：

```text
实时分析用户学习状态与专注度
```

并提供：

- 坐姿提醒
- 环境优化建议
- 疲劳检测
- 学习时长统计

------

# 二、整体系统架构

整体采用：

```text
感知层
↓
无线边缘节点层
↓
STM32H7边缘AI主控层
↓
多模态融合层
↓
LVGL交互层
```

属于典型：

```text
IoT + Edge AI + Embedded System
```

架构。

------

# 三、系统模块划分

# 1️⃣ 摄像头视觉模块（AI视觉）

## 硬件

- OV2640

## 接口

- DCMI + DMA

## 功能

用于：

- 人脸区域采集
- 专注状态识别
- 疲劳检测

## AI流程

```text
OV2640
↓
ROI裁剪
↓
灰度化
↓
缩放(32x32)
↓
CubeAI推理
↓
输出：
- 专注
- 分心
- 疲劳
```

------

# 2️⃣ 环境监测模块

## 传感器

| 传感器 | 功能 |
| --- | --- |
| BH1750 | 光照检测 |
| AHT20/SHT30 | 温湿度检测 |
| 麦克风模块  | 环境噪音检测 |
| WiFi天气API | 外部天气信息 |

## 功能

用于分析：

```text
当前环境是否适合学习
```

------

# 3️⃣ 无线椅子节点（IoT边缘节点）

这是项目的重要创新点。

------

## 从机MCU

Nordic nRF52832

------

## 传感器

| 模块 | 功能 |
| --- | --- |
| 压力传感器 | 检测是否坐下 |
| MPU6050 | 姿态检测 |

------

## 数据采集方式

### 压力传感器

- ADC采集
- 阈值判断

### MPU6050

- I2C读取
- Motion Interrupt中断唤醒

------

## BLE通信流程

```text
压力/姿态变化
↓
唤醒nRF52832
↓
采集数据
↓
BLE发送
↓
STM32H7接收
↓
重新Sleep
```

------

## 低功耗设计

系统采用：

```text
Sleep
↓
中断唤醒
↓
采集
↓
BLE发送
↓
重新Sleep
```

低功耗IoT架构。

------

# 4️⃣ STM32H7主控系统（系统核心）

STM32H7 是整个系统的大脑。

------

## 主要职责

| 功能 | 内容 |
| --- | --- |
| 摄像头采集 | OV2640图像采集 |
| AI推理 | CubeAI运行 |
| BLE通信 | 接收椅子数据 |
| 环境采集 | I2C传感器读取  |
| GUI显示 | LVGL |
| 网络功能 | 天气获取 |
| 系统调度 | FreeRTOS |

------

# 四、AI架构

# CubeAI边缘AI模型

------

## 部署平台

STM32H7

------

## 模型类型

轻量CNN

------

## 输入

```text
32x32灰度Face ROI
```

------

## 输出

| 状态 |
| ---- |
| 专注 |
| 分心 |
| 疲劳 |

------

## 设计原则

禁止：

```text
复杂微表情识别
```

原因：

- MCU资源有限
- 提高实时性
- 提高稳定性
- 提高比赛成功率

------

# 五、多模态融合系统（核心创新）

这是本项目最重要的创新点。

------

# 数据来源

| 数据源 | 内容 |
| --- | --- |
| AI视觉 | 专注状态 |
| 姿态检测 | 坐姿状态 |
| 环境检测 | 光照/噪音/温湿度 |
| 时间系统 | 连续学习时长 |

------

# 融合输出

输出：

```text
最终专注度评分
0~100
```

例如：

```text
专注度 =
40% AI视觉
+
30% 坐姿
+
20% 环境
+
10% 学习时长
```

------

# 六、GUI交互系统（LVGL）

# UI定位

系统不是：

```text
摄像头监控器
```

而是：

```text
智能学习状态仪表盘
```

------

# 主界面显示内容

| 信息 | 内容 |
| --- | --- |
| 当前时间 | 时间日期 |
| 天气信息 | 天气/温度 |
| 专注度 | 0~100 |
| 坐姿状态 | 正常/异常 |
| 环境评分 | 环境质量 |
| 学习时长 | 连续学习时间  |
| AI建议 | 环境/状态提醒 |

------

# UI原则

必须：

```text
极简
低干扰
产品化
```

默认禁止：

```text
实时摄像头画面
```

摄像头仅允许：

```text
调试模式
```

显示。

------

# 七、FreeRTOS系统架构

系统基于：

```text
FreeRTOS
```

进行任务调度。

------

# 任务划分

| 任务 | 功能 |
| --- | --- |
| CameraTask  | 摄像头采集 |
| AITask | CubeAI推理 |
| SensorTask  | 环境采集 |
| BLETask | BLE通信 |
| GUITask | LVGL刷新 |
| NetworkTask | 天气获取 |

------

# 八、系统运行流程

# ① 用户开始学习

```text
按下“开始学习”
```

------

# ② 系统确认用户在位

```text
压力传感器检测到有人
```

------

# ③ 系统启动

启动：

- 摄像头
- AI分析
- BLE通信
- 环境监测
- GUI更新

------

# ④ CubeAI识别学习状态

输出：

```text
专注
分心
疲劳
```

------

# ⑤ 多模态融合

计算：

```text
最终专注度评分
```

------

# ⑥ LVGL显示结果

例如：

```text
专注度：82
环境评分：75
坐姿状态：正常
连续学习：42分钟
```

------

# 九、项目核心亮点

# 本项目核心创新：

```text
多模态边缘AI学习状态感知
```

融合：

- AI视觉
- 姿态检测
- 环境分析
- IoT无线节点
- 边缘AI推理
- 实时GUI交互

形成：

```text
Embedded AI + IoT + Human State Perception
```

综合智能学习辅助系统。

------

# 十、项目设计原则

# 核心思想

## 1️⃣ 先闭环再扩展

优先实现：

```text
摄像头
↓
CubeAI
↓
专注识别
↓
GUI显示
```

再逐步增加：

- 环境监测
- BLE椅子节点
- 多模态融合

------

## 2️⃣ 稳定性优先

比赛中：

```text
稳定演示
>
复杂功能
```

------

## 3️⃣ 产品化优先

目标不是：

```text
传感器拼接实验
```

而是：

```text
真正智能学习终端
```
