luruicheng891/Study-Focus-Meter/Communication/UART_ESP32.h

/**
  ******************************************************************************
  * @file    UART_ESP32.h
  * @brief   USART2 (ESP32 BLE 透传) 底层接收驱动
  *          USART2 + DMA1_Stream3 + IDLE 中断, 仅负责把 UART 字节流分帧。
  *          业务层 (JSON 解析 / 队列发布) 见 Task/SlaveRxTask.{c,h}
  *
  * 接收链路:
  *   ESP32 → BLE 透传 (W02 / PB-03F) → USART2 RX (PA3)
  *      └── DMA1_Stream3 → AXI SRAM 0x24040D00 (256 字节循环缓冲)
  *           └── IDLE 中断: 计算本帧长度 → DCache invalidate
  *                          → 拷到帧缓冲 → 唤醒注册的任务
  *
  * 与上层的解耦方式:
  *   1. 上层调用 UART_ESP32_BindRxTask(handle) 注册自己的 TaskHandle_t
  *   2. ISR 收到完整帧后 vTaskNotifyGiveFromISR 唤醒该任务
  *   3. 上层 ulTaskNotifyTake 后调用 UART_ESP32_TakeFrame() 拷出原始字节
  *   4. 上层做 JSON / 协议解析, 本驱动一律不参与
  ******************************************************************************
  */

#ifndef __UART_ESP32_H
#define __UART_ESP32_H

#include "stm32h7xx_hal.h"
#include "FreeRTOS.h"
#include "task.h"
#include <stdint.h>

#ifdef __cplusplus
extern "C" {
#endif

/* ============================ 配置参数 ============================ */

#define USART2_BAUDRATE         9600
#define USART2_RX_BUFFER_SIZE   256

/* DMA RX 缓冲区物理地址 (AXI SRAM)
 *   0x24040000~0x240407FF : LCD ping-pong (2KB)
 *   0x24040800~0x240408FF : USART3 RX (ESP-01, 256B)
 *   0x24040900~0x24040CFF : MAX9814 ADC (1KB)
 *   0x24040D00~0x24040DFF : USART2 RX (本驱动, 256B)
 */
#define USART2_RX_DMA_ADDR      0x24040D00

/* ============================ 全局对象 ============================ */

extern UART_HandleTypeDef huart2;

/* ============================ 底层 API ============================ */

/**
  * @brief  初始化 USART2 + DMA + IDLE 中断, 启动循环接收
  */
void USART2_Init(void);

/**
  * @brief  USART2 中断分派 (在 stm32h7xx_it.c 的 USART2_IRQHandler 中调用)
  */
void USART2_IRQ_Handler(void);

/**
  * @brief  绑定上层接收任务
  * @param  handle  上层任务句柄, ISR 完帧后会 vTaskNotifyGiveFromISR(handle)
  * @note   传 NULL 可解除绑定。一次只能绑定一个任务。
  */
void UART_ESP32_BindRxTask(TaskHandle_t handle);

/**
  * @brief  从内部帧缓冲拷出最近一帧原始字节
  * @param  buf      用户缓冲区
  * @param  max_len  buf 最大可写字节数 (建议 ≥ USART2_RX_BUFFER_SIZE + 1)
  * @param  out_len  实际拷出的字节数 (含末尾 '\0' 之前的有效长度)
  * @retval 0   成功拷出一帧, 调用方可继续解析
  * @retval -1  当前没有就绪帧 (例如刚被消费过, 或 buf 太小)
  * @note   函数内部使用临界区保证与 ISR 的互斥。
  */
int UART_ESP32_TakeFrame(uint8_t *buf, uint16_t max_len, uint16_t *out_len);

/**
  * @brief  读取底层接收统计 (可选, 用于调试)
  * @param  recv  累计完整帧数, 可传 NULL
  * @param  drop  上层来不及消费导致丢弃的帧数, 可传 NULL
  */
void UART_ESP32_GetStats(uint32_t *recv, uint32_t *drop);

/* ============================ 发送 API ============================ */

/**
  * @brief  通过 USART2 (PA2=TX) 向 ESP32 发送原始字节 (阻塞)
  * @param  data  数据指针
  * @param  len   字节数
  * @retval 0   发送成功
  * @retval -1  参数错误
  * @retval -2  HAL 发送失败 / 超时
  * @note   TX 与 RX DMA 互不干扰: HAL UART 用独立的 gState (TX) 与
  *         RxState (RX) 状态机, 阻塞发送不会打断循环接收 DMA。
  *         指令通常很短 (< 64 字节), 内部用 100ms 超时。
  */
int UART_ESP32_SendBytes(const uint8_t *data, uint16_t len);

/**
  * @brief  向 ESP32 发送单字节指令 (供业务层封装协议使用)
  * @param  cmd  单字节指令 (如 'A'/'Z'/'S')
  * @retval 同 UART_ESP32_SendBytes
  */
int UART_ESP32_SendByte(uint8_t cmd);

/* ============================ 低功耗唤醒辅助 ============================ */

/**
  * @brief  获取 DMA 缓冲区地址 (供 PowerManager 重启 DMA 接收)
  * @note   从 Stop 唤醒后需要重建 DMA 状态, 需要访问缓冲区地址
  */
uint8_t *UART_ESP32_GetDMABuffer(void);

#ifdef __cplusplus
}
#endif

#endif /* __UART_ESP32_H */
