luruicheng891/Study-Focus-Meter/Task/display_mode.h

/**
  ******************************************************************************
  * @file    display_mode.h
  * @brief   屏幕显示模式运行时切换 (主仪表板 / 摄像头画面 / 天气预报)
  *
  *          USART1 RX 命令通道已禁用, 不再响应外部 'C'/'W' 字符.
  *          模式切换仅通过 DisplayMode_Request() API (任务上下文) 完成,
  *          例如: 摄像头画面上的按钮回调, 天气仪表板上的按钮回调.
  ******************************************************************************
  */
#ifndef __DISPLAY_MODE_H
#define __DISPLAY_MODE_H

#include <stdint.h>

typedef enum {
    DISP_MODE_CAMERA   = 0,  /* 显示摄像头画面 */
    DISP_MODE_WEATHER   = 1, /* 显示主仪表板 (时钟 + 室内温湿度) */
    DISP_MODE_FORECAST  = 2, /* 显示天气预报子界面 (网络天气详情) */
} DisplayMode_t;

/* 当前显示模式 (volatile, 任务共享) */
extern volatile DisplayMode_t g_display_mode;

/**
 * @brief 请求切换显示模式
 * @note  实际 LVGL UI 切换在 DisplayTask 中执行, 保证线程安全
 */
void DisplayMode_Request(DisplayMode_t mode);

/**
 * @brief 获取并清除待处理的模式切换请求
 * @retval 1 = 有新请求, *out_mode 有效; 0 = 无请求
 * @note   仅 LVGL 任务调用
 */
int DisplayMode_TakePending(DisplayMode_t *out_mode);

/**
 * @brief 启动 USART1 (兼容旧接口, 当前实现为关闭 RX 命令通道)
 *        在 main.c 中, USART1_Init() 完成后调用
 */
void DisplayMode_StartUart1Rx(void);

/* ===================== 摄像头抓拍 (数据采集) ===================== */
/**
 * @brief 请求抓拍一帧 (由 USART1 RX 收到 'P'/'p' 命令时在 ISR 中置位)
 * @note  也可在任务上下文手动调用 (例如触摸按钮回调)
 */
void DisplayMode_RequestCapture(void);

/**
 * @brief 取出并清除抓拍请求标志
 * @retval 1 = 有抓拍请求; 0 = 无
 * @note   由 Camera_task 主循环轮询
 */
int DisplayMode_TakeCaptureRequest(void);

/**
 * @brief USART1 原始字节阻塞发送 (独占 TDR, 临时冻结 printf 环形缓冲 TX)
 *        用于把整帧图像 dump 到上位机, 期间会 taskYIELD 让出 CPU.
 * @param data 待发送数据
 * @param len  字节数
 */
void USART1_SendRaw_Blocking(const uint8_t *data, uint32_t len);

#endif
