luruicheng891/Study-Focus-Meter/(commit log)

2026-05-14 第一次提交，解决了摄像头采集图像并通过串口显示
2026-05-15 把OV2640采集到的画面显示到LCD屏幕中，移植了ILI9341芯片的LCD屏幕，成功显示
2026-05-15 继续优化，根本原因是LCD和DCMI存在GPIO引脚冲突：PE5（SPI4_MISO与DCMI_D6）和PE6（SPI4_MOSI与DCMI_D7）冲突导致LCD无法通信，PD3（背光控制与DCMI_D5）冲突导致背光失控而闪烁。代码中先执行LCD_Init()将PD3配置为GPIO输出点亮背光，随后DCMI_OV2640_Init()将PD3重新配置为DCMI_D5的复用功能，使PD3不再受G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
2026-05-15 修复屏幕闪烁
2026-05-16 移植Freertos,但未划分任务
2026-05-16 成功使用Freertos运行Camera任务
2026-05-21 修改原来的阻塞式SPI改为SPI +DMA发送
2026-05-23 新增 AHT20 任务：初始化失败自杀，成功则继续
2026-05-24 移植LVGL，并将摄像头采集的画面实时显示在LVGL界面上
2026-05-26 在屏幕上显示温湿度值
2026-05-31 V1.3: LCD 切横屏 320x240; 新增 Task/display_mode.c 通过 USART1 命令切换显示 ('C'摄像头/'W'天气, 两模式相对 180 度翻转); 重做横屏天气仪表板 (Hero卡+INDOOR卡, 启用 Montserrat 20/28pt); 重写 fputc 为环形缓冲+TXE中断非阻塞 修复多任务 printf 卡死; USART1 RX 走寄存器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
    [BH1750.c, BH1750.h, Camera.c, SensorTask.c, SensorTask.h, UART.c, UART.h]
2026-06-06 更新了UI
2026-06-06 优化文件
2026-06-08 增加MAX9814驱动，获取音量值，优化LVGL的UI
2026-06-11 新增触摸功能,增加主界面与摄像头界面的触摸切换功能
2026-06-11 优化触摸
2026-06-16 feat: 智瞳伴学v1.0 完整发布
2026-06-20 Feat 新增BLE节点和多模态融合算法
2026-06-21 feat: 新增学习时长选择与自动息屏功能
2026-06-25 feat:优化UI,增加上传学习信息至MQTT服务器
2026-06-26 增加BLE节点,采集椅子的压力和姿态,用于评分
2026-11-07 feat: 4类模型集成 + Stop低功耗 + 天气/倒计时UI改版
    - AI: 集成 X-CUBE-AI 4类模型(专心/走神/玩手机/无人), moxing/ 生成工程入库,
    Fusion/State/Reminder/Report 全链路适配, 新增"持续玩手机5min"提醒
    - 低功耗: 新增 PowerManager(Stop模式, 触摸PEN+RTC唤醒), RTC(LSE)脱网走时,
    唤醒后重建 USART1/3 DMA 接收
    - UI: 显示模式扩为 主仪表板/摄像头/天气预报 三态, 新增 WeatherScreen;
    学习页中央改为 MM:SS 倒计时, 支持串口 'P' 抓拍采集数据
    - 清理: 移除 MDK-ARM/.cmsis 及 Keil 编译产物
